anthnt/RSS_Capstone2021/CAD/DRAWINGS/Supplier Drawings/M13_4CQ4-PKG.JPG

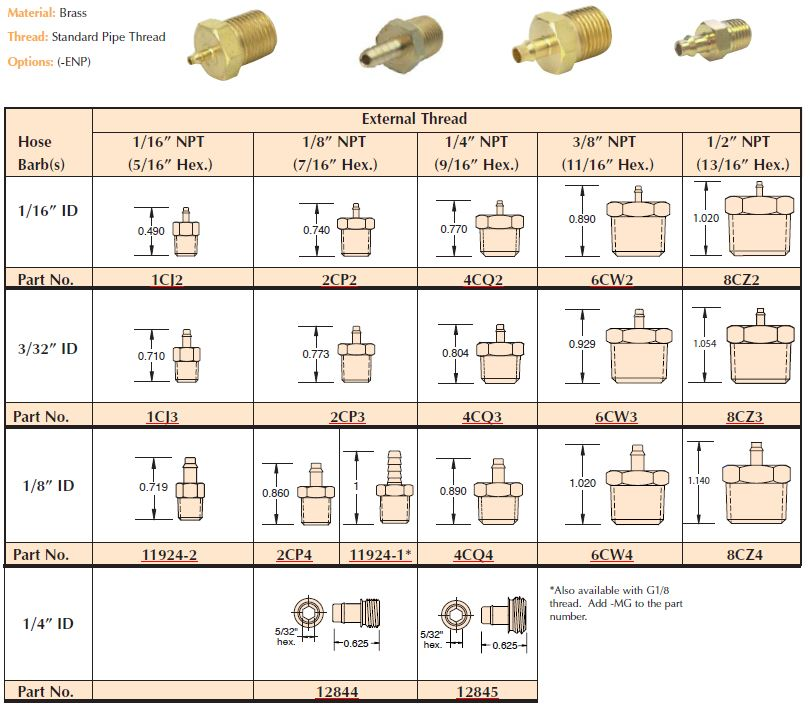
CAD/DRAWINGS/Supplier Drawings/M13_4CQ4-PKG.JPG
