anthnt/RSS_Capstone2021/CAD/DRAWINGS/Old/Not Necesssary/BOM.xlsx

ITEM NO. | PART NAME | DESCRIPTION | QTY
M1 | 4 x 10mm Manifold E10M-04 |  | 1
M2 | Ninja Cannister and First Stage Regulator |  | 1
M3 | Ninja Universal Fill Adapter (Not Depicted) |  | 1
M4 | Solenoid Valve E210A-1W012 |  | 4
M5 | 1/4" OD Nylon Tubing |  | 1
M6 | 1/8" ID Polyurethane Rubber Tubing |  | 1
M7 | 1/16" ID Polyurethane Rubber Tubing |  | 1
M9 | 1/4" Speedaire Regulator |  | 1
M10 | 1/8" ID Barb #10-32 Male Thread |  | 1
M11 | 1/16" ID Barb #10-32 Male Thread |  | 4
M12 | 1/8" NPT to 1/16" ID Barb (Not Depicted) |  | 1
M13 | 1/4” NPT to 1/8” ID Barb Fitting |  | 1
M14 | 1/8" FITTING PIPE PLUG SQUARE HEAD 1/8IN |  | 1
M17 | GAUGE CENTRE BACK MOUNT 0 - 160 PSI |  | 1
M18 | Brass Barbed Fittings ID 3/16" x 1/4" NTP Male |  | 1
M19 | Brass Barbed Fittings ID 3/16" x 1/8" NTP Male |  | 1
M20 | Creality 0.4mm Brass Nozzle |  | 4
M21 | 1/16" Barb ID x M6 x 1mm Male, Aluminum Low-Pressure |  | 4
M22 | 3 Nozzle Holder |  | 1
M23 | Load Cell Plate |  | 1
M24 | Nozzle Mount |  | 1
M25 | M2.5 x 0.45 mm, 15 mm long, 18-8 Stainless Steel Socket Head Screw |  | 4
M26 | M2.5 x 0.45 mm thread 18-8 Stainless Steel Hex Nut |  | 4
M27 | M6 x 1mm Thread Coupling Nut |  | 4
M28 | Air Cannister Holder |  | 2
M29 | Air Cannister Bracket |  | 2
M30 | Manifold Stand |  | 1
M31 | Base |  | 1
M32 | Second Stage Regulator Stand-Offs |  | 4
E5 | Load Cell |  | 1
