anthnt/RSS_Capstone2021/CAD/DRAWINGS/Supplier Drawings/M01_Manifold_E10M-04.jpg

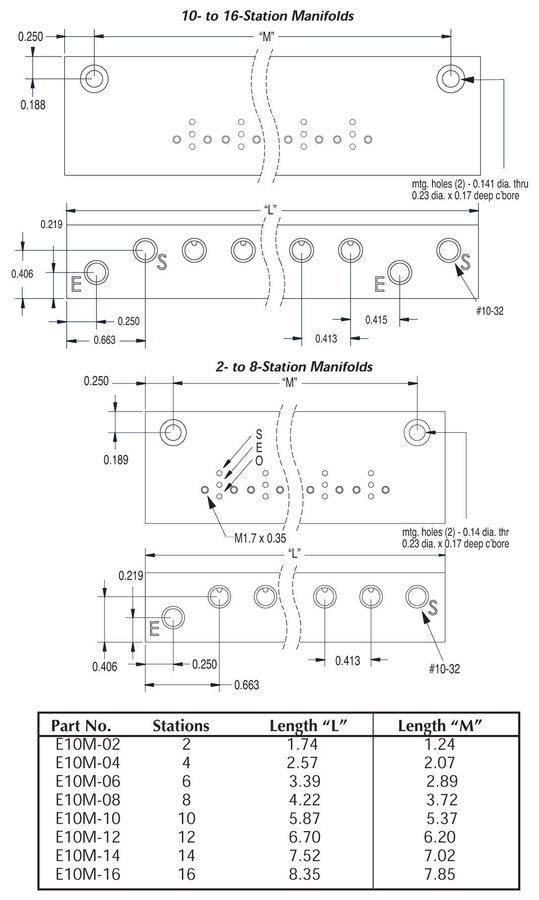
CAD/DRAWINGS/Supplier Drawings/M01_Manifold_E10M-04.jpg
