anthnt/RSS_Capstone2021/CAD/DRAWINGS/Supplier Drawings/M10_11752-4-pkg.jpg

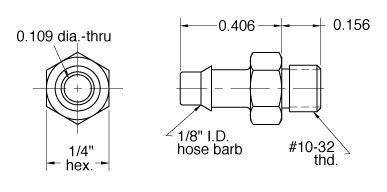
CAD/DRAWINGS/Supplier Drawings/M10_11752-4-pkg.jpg
