anthnt/RSS_Capstone2021/CAD/DRAWINGS/Supplier Drawings/M11_11752-5-pkg.jpg

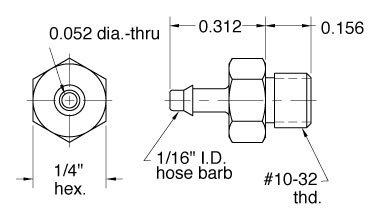
CAD/DRAWINGS/Supplier Drawings/M11_11752-5-pkg.jpg
