anthnt/RSS_Capstone2021/CAD/ASSM - Air Cannister/M2_NInja Canister and 1st Stage Regulator.SLDASM

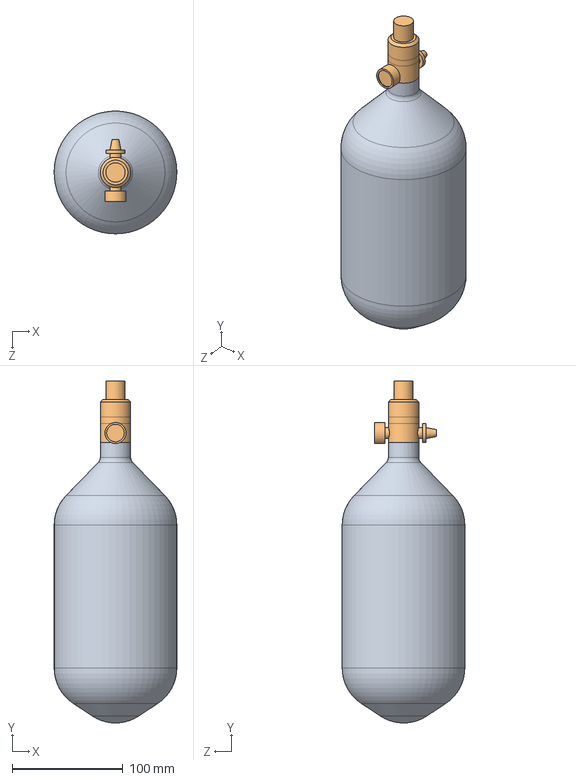
[picture p5: CAD file, 2022-05-25]
CAD/ASSM - Air Cannister/M2_NInja Canister and 1st Stage Regulator.SLDASM
110.7 x 308.5 x 110.7 mm
Ninja_NINJATANKSL2-90_(Air Canister)
Ninja_BLKRED-PROV2SL_(SLP Regulator)
