anthnt/RSS_Capstone2021/CAD/ASSM - 3 Nozzle Section/SUB_3 Nozzle Base Assmebly.SLDASM

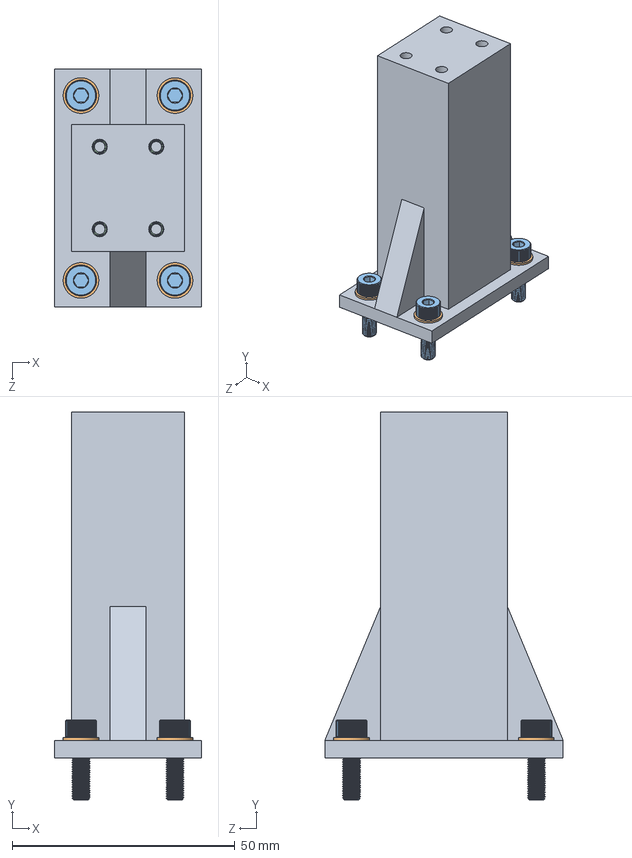
[picture p6: CAD file, 2022-05-25]
CAD/ASSM - 3 Nozzle Section/SUB_3 Nozzle Base Assmebly.SLDASM
33.1 x 87.1 x 53.5 mm
M22b_3 Nozzle Holder
M38_98689A113_General Purpose 18-8 Stainless Steel Washer x 4
M37_90751A118_18-8 Stainless Steel Socket Head Screws x 4
M42_91828A211_18-8 Stainless Steel Hex Nut x 4
