anthnt/RSS_Capstone2021/CAD/ASSM - Air Cannister/SUB_Air Canister Assembly.SLDASM

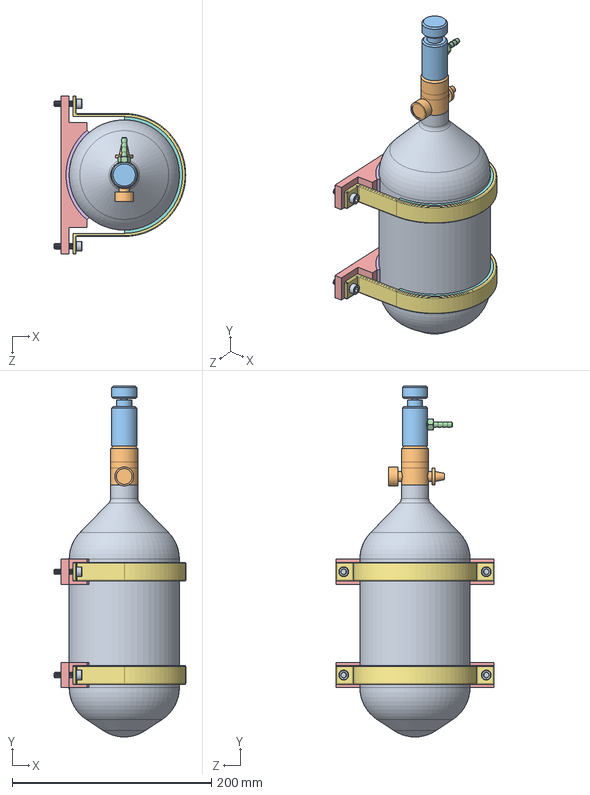
[picture p7: CAD file, 2022-05-25]
CAD/ASSM - Air Cannister/SUB_Air Canister Assembly.SLDASM
132.0 x 352.4 x 159.1 mm
Ninja_NINJATANKSL2-90_(Air Canister)
Ninja_BLKRED-PROV2SL_(SLP Regulator)
M3_Ninja_NINJATANK-FILLADAPTER_(Universal Fill Adapter)
M19_5346K11_Brass Barbed Hose Fitting for Air and Water
M28_Air Cannister Holder x 2
M33_Holder Rubber x 2
M29_Air Cannister Bracket x 2
M33_Bracket Rubber x 2
M35_91292A073_18-8 Stainless Steel Socket Head Screw x 4
