anthnt/RSS_Capstone2021/CAD/ASSM - Electrical Board/ElectricalAssembly.SLDASM

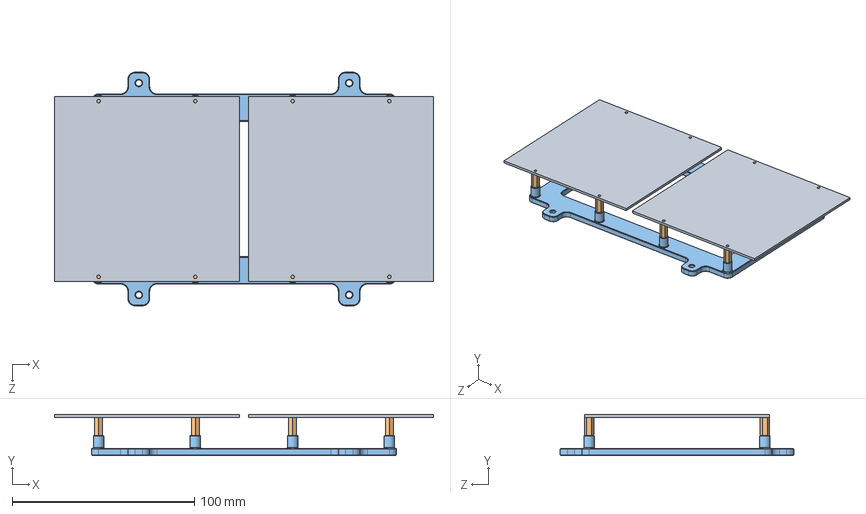
[picture p8: CAD file, 2022-05-25]
CAD/ASSM - Electrical Board/ElectricalAssembly.SLDASM
208.2 x 22.6 x 128.4 mm
PCB x 2
93655A096_Male-Female Threaded Hex Standoff x 8
ElectricalBoard_V2
