anthnt/RSS_Capstone2021/CAD/ASSM - Nozzle Assembly/Custom Nozzle Assembly.SLDASM

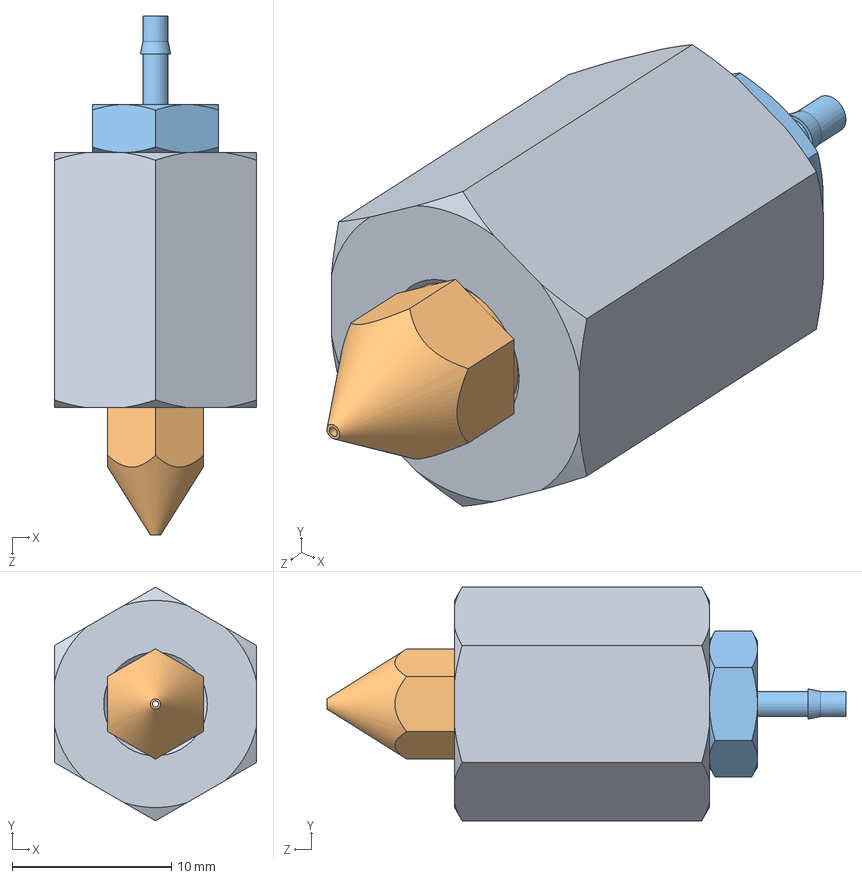
[picture p9: CAD file, 2022-05-25]
CAD/ASSM - Nozzle Assembly/Custom Nozzle Assembly.SLDASM
12.7 x 14.7 x 32.6 mm
M27_93020A775_LOW-STRENGTH STL HEX CPLG NUT
M20_Creality Brass Nozzle
M21_5058K956_ALUMINUM LOW-PRESSURE BARBED TUBE FITTING
