anthnt/RSS_Capstone2021/CAD/ASSM - Solenoid Valves and Manifold/M04_valve_e210a-1w012.SLDASM

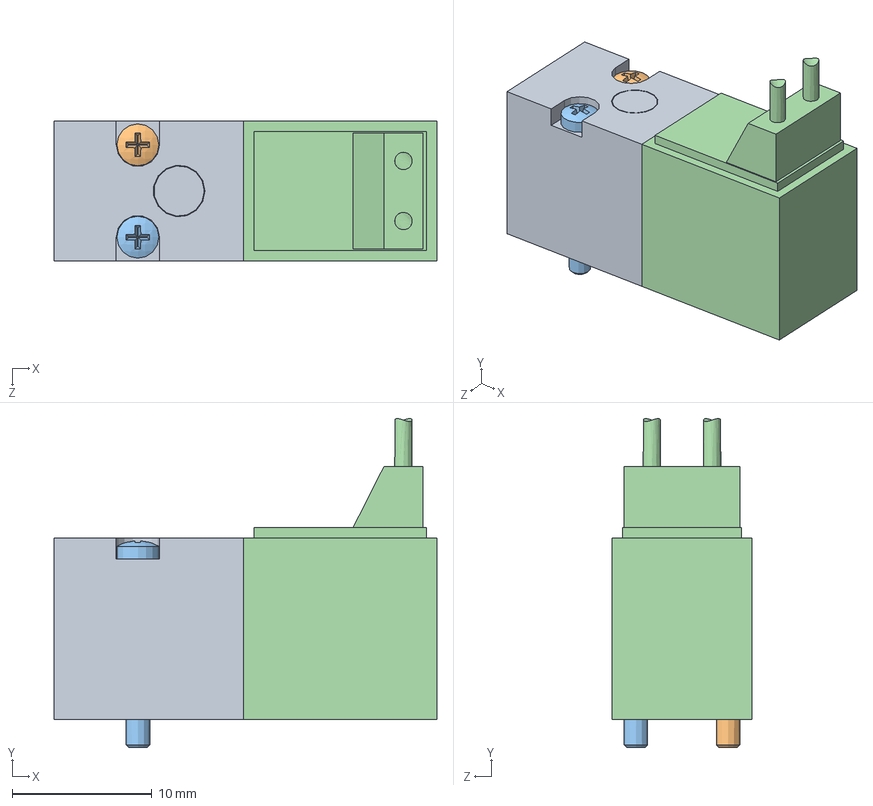
[picture p10: CAD file, 2022-05-25]
CAD/ASSM - Solenoid Valves and Manifold/M04_valve_e210a-1w012.SLDASM
27.4 x 23.5 x 10.0 mm
valve_e210a-1w012_01
valve_e210a-1w012_02
valve_e210a-1w012_03
valve_e210a-1w012_04
