anthnt/RSS_Capstone2021/CAD/ASSM - Load Cell/SUB_Load Cell Mounting Assembly.SLDASM

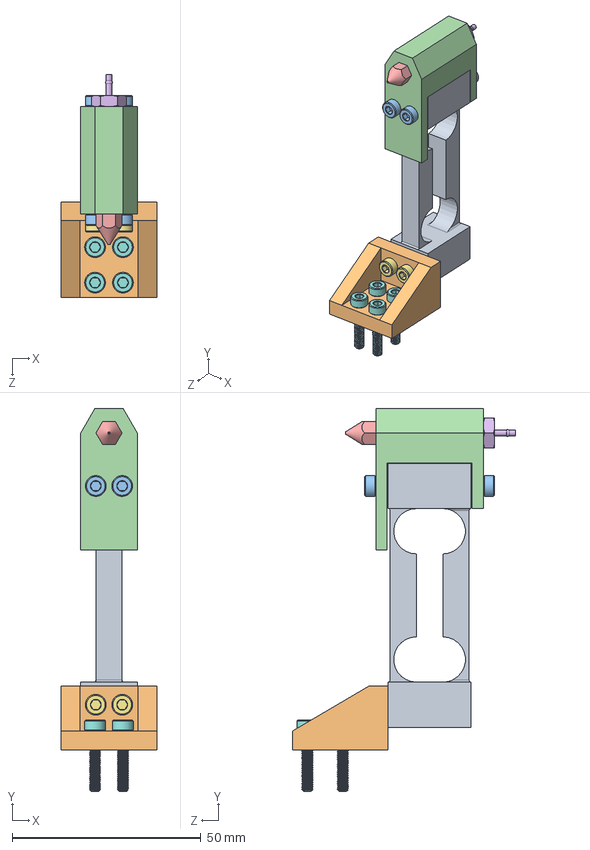
[picture p11: CAD file, 2022-05-25]
CAD/ASSM - Load Cell/SUB_Load Cell Mounting Assembly.SLDASM
25.4 x 101.5 x 59.2 mm
E05_Load Cell
M23_Load Cell Bracket
M44_91292A113_18-8 Stainless Steel Socket Head Screw x 4
M24_Nozzle Mount
M20_Creality Brass Nozzle
M21_5058K956_ALUMINUM LOW-PRESSURE BARBED TUBE FITTING
M41_91292A801_18-8 Stainless Steel Socket Head Screw x 2
M25_91292A115_18-8 Stainless Steel Socket Head Screw x 4
