anthnt/RSS_Capstone2021/CAD/ASSM - Solenoid Valves and Manifold/SUB_Solenoid Assembly.SLDASM

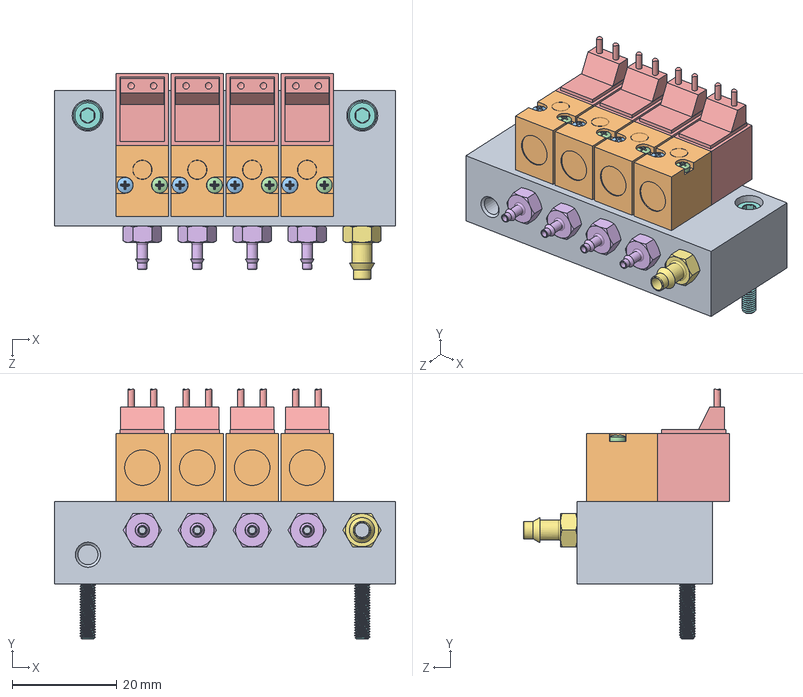
[picture p12: CAD file, 2022-05-25]
CAD/ASSM - Solenoid Valves and Manifold/SUB_Solenoid Assembly.SLDASM
65.2 x 47.8 x 39.5 mm
M01_manifold_e10m-04
valve_e210a-1w012_01 x 4
valve_e210a-1w012_02 x 4
valve_e210a-1w012_03 x 4
valve_e210a-1w012_04 x 4
M11_11752-5-pkg x 4
M10_11752-4-pkg
91292A801_18-8 Stainless Steel Socket Head Screw x 2
