anthnt/RSS_Capstone2021/CAD/ASSM - 3 Nozzle Section/SUB_3 Nozzle Block Assembly.SLDASM

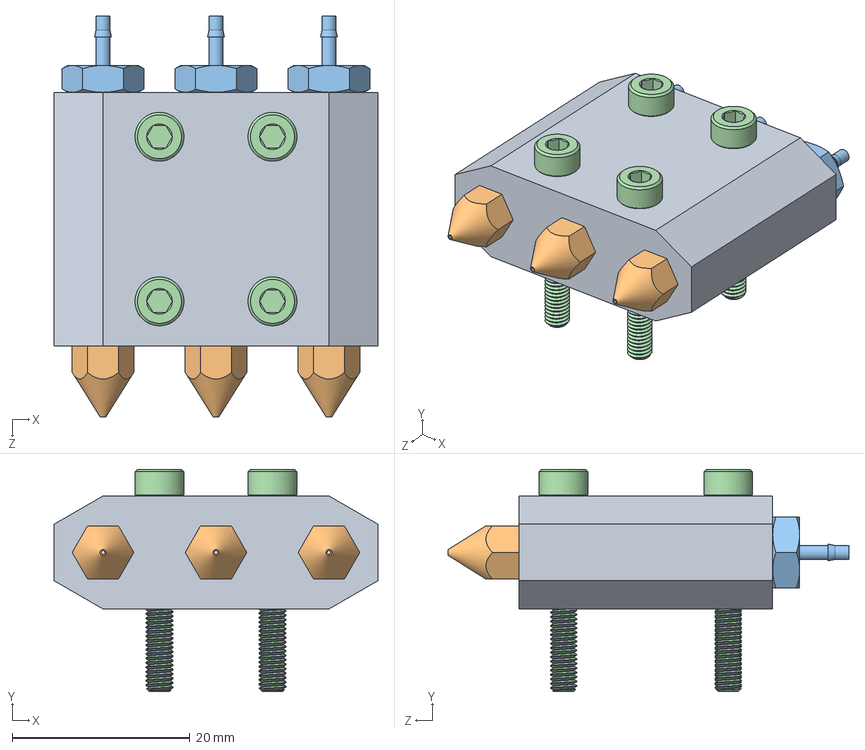
[picture p13: CAD file, 2022-05-25]
CAD/ASSM - 3 Nozzle Section/SUB_3 Nozzle Block Assembly.SLDASM
36.4 x 25.0 x 45.1 mm
M22a_3 Nozzle Block
M20_Creality Brass Nozzle x 3
M21_5058K956_ALUMINUM LOW-PRESSURE BARBED TUBE FITTING x 3
M41_91292A801_18-8 Stainless Steel Socket Head Screw x 4
