anthnt/RSS_Capstone2021/CAD/ASSM - Load Cell/SUB_Calibration Stand Mounting Assembly.SLDASM

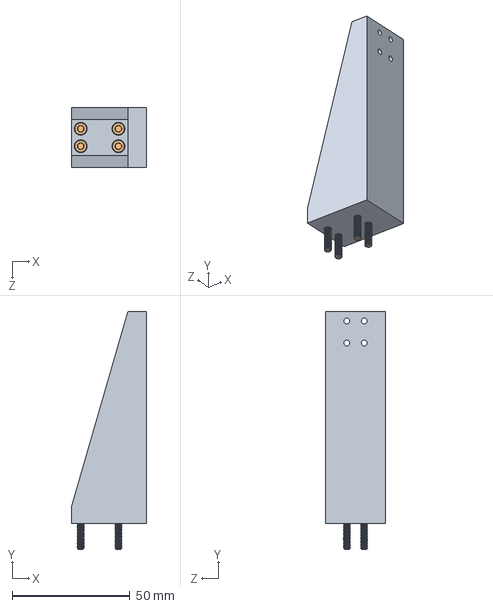
[picture p14: CAD file, 2022-05-25]
CAD/ASSM - Load Cell/SUB_Calibration Stand Mounting Assembly.SLDASM
32.0 x 101.0 x 25.4 mm
M40_Calibration Stand
M43_91292A029_18-8 Stainless Steel Socket Head Screw x 4
