anthnt/RSS_Capstone2021/CAD/ASSM - Second Stage Regulator/SUB_Second Stage Regulator Assembly.SLDASM

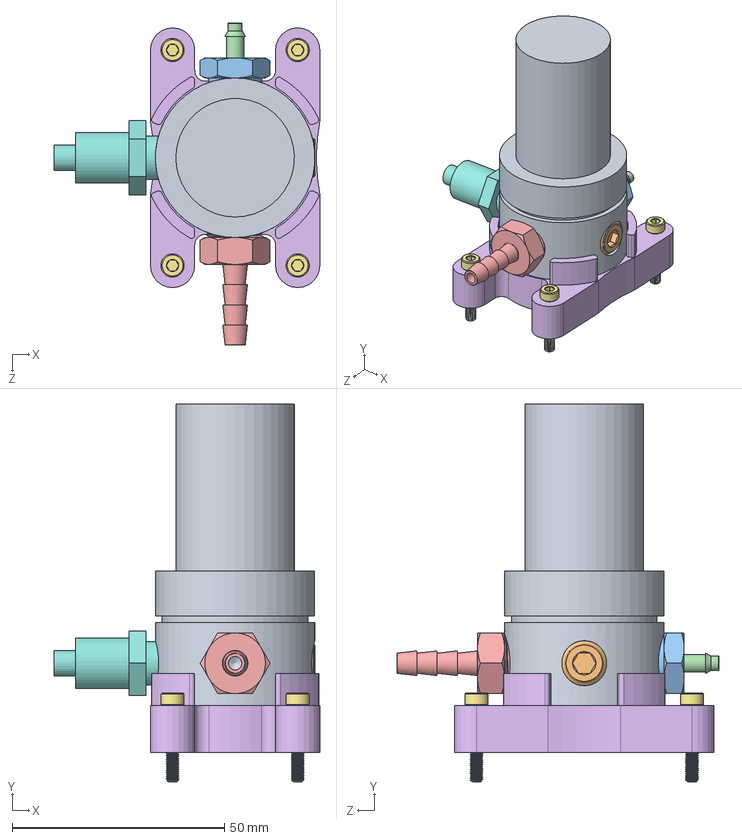
[picture p15: CAD file, 2022-05-25]
CAD/ASSM - Second Stage Regulator/SUB_Second Stage Regulator Assembly.SLDASM
62.6 x 89.1 x 76.0 mm
Grainger_4ZM06_(Pressure Regulator)
MCMASTER_4464K561_(0.125 NPT Plug Fitting)
4cq4-pkg_01
4cq4-pkg_02
M18_5346K12_Brass Barbed Hose Fitting for Air and Water
Regulator Base Fixture
M43_91292A029_18-8 Stainless Steel Socket Head Screw x 4
Pressure Transducer
