anthnt/RSS_Capstone2021/CAD/ASSM - Second Stage Regulator/4cq4-pkg.SLDASM

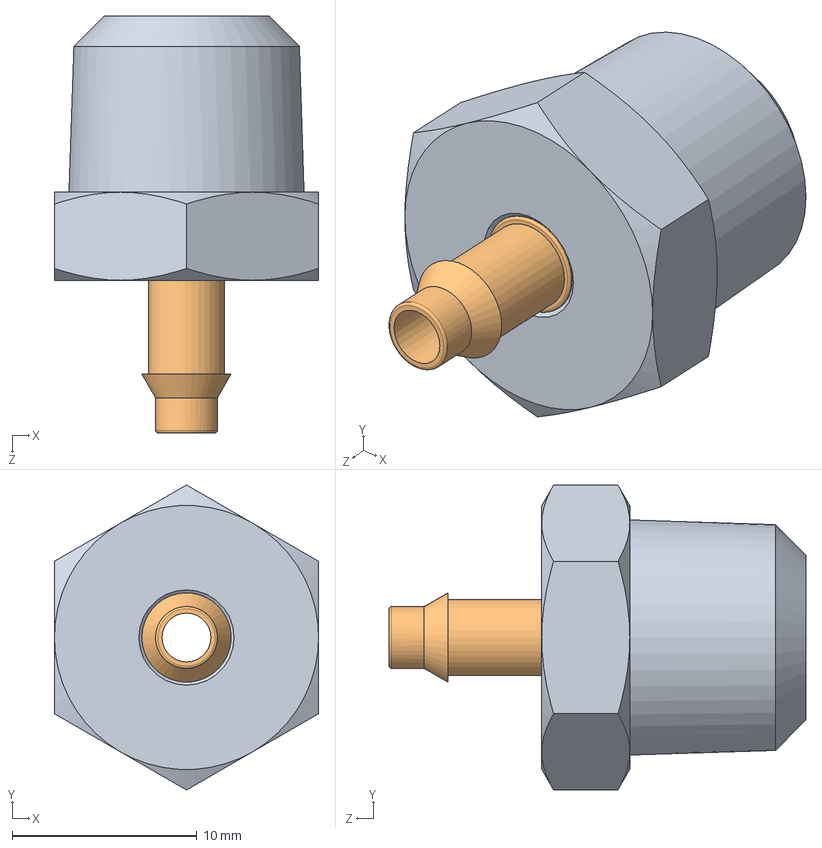
[picture p16: CAD file, 2022-05-25]
CAD/ASSM - Second Stage Regulator/4cq4-pkg.SLDASM
14.3 x 16.5 x 22.5 mm
4cq4-pkg_01
4cq4-pkg_02
