anthnt/RSS_Capstone2021/CAD/ASSM - Electrical Board/ElectricalBoard_V2.SLDPRT

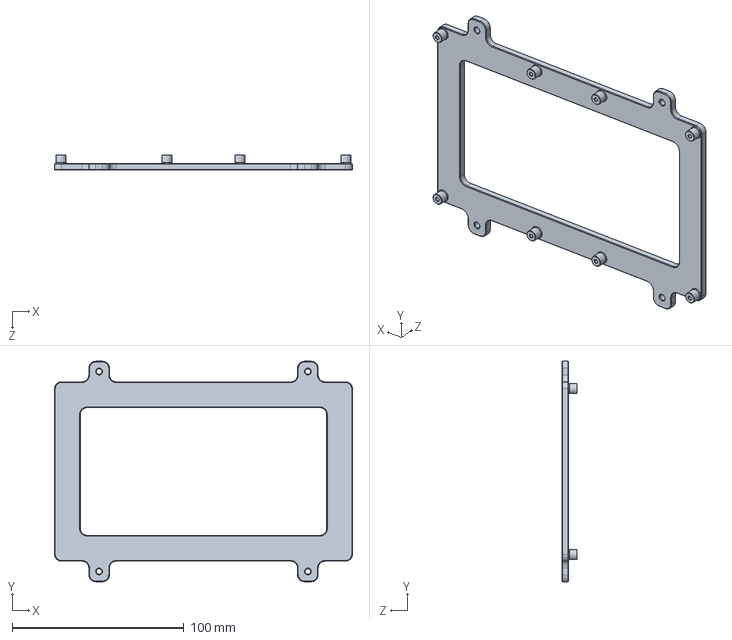
[picture p17: CAD file, 2022-05-25]
CAD/ASSM - Electrical Board/ElectricalBoard_V2.SLDPRT
173.5 x 128.4 x 9.00 mm
