anthnt/RSS_Capstone2021/CAD/ASSM - Nozzle Assembly/M20_Creality Brass Nozzle.SLDPRT

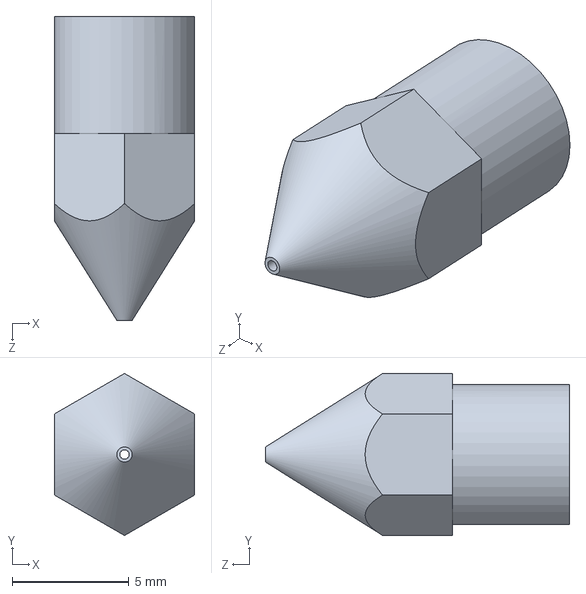
[picture p18: CAD file, 2022-05-25]
CAD/ASSM - Nozzle Assembly/M20_Creality Brass Nozzle.SLDPRT
6.00 x 6.93 x 13.0 mm
