anthnt/RSS_Capstone2021/CAD/ASSM - Prototyping Bed/PrototypeBase.SLDPRT

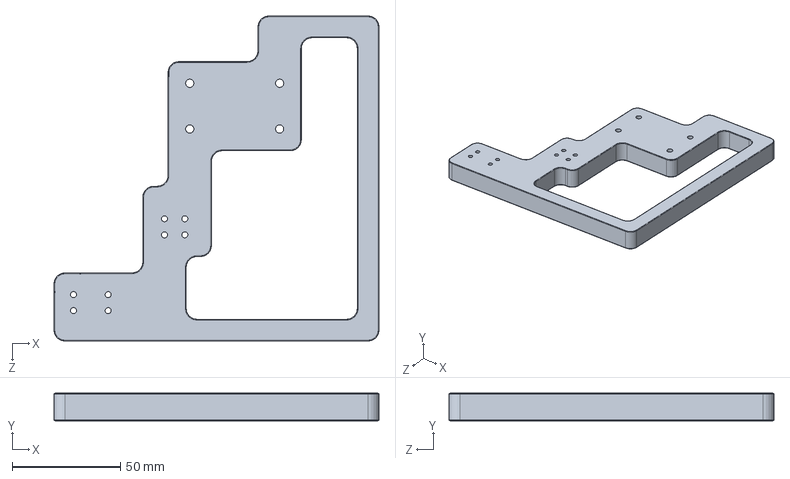
[picture p19: CAD file, 2022-05-25]
CAD/ASSM - Prototyping Bed/PrototypeBase.SLDPRT
150.0 x 12.7 x 150.0 mm
