anthnt/RSS_Capstone2021/CAD/Base.SLDPRT

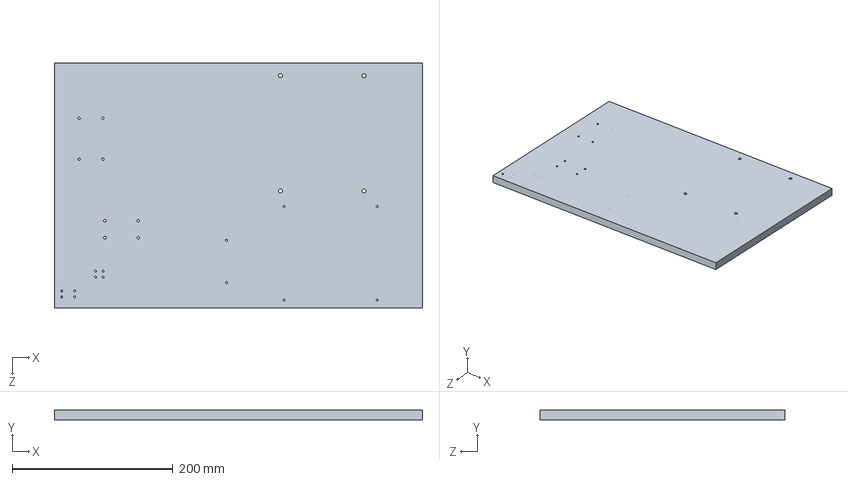
[picture p20: CAD file, 2022-05-25]
CAD/Base.SLDPRT
457.2 x 12.7 x 304.8 mm
