anthnt/RSS_Capstone2021/CAD/DRAWINGS/Air Cannister Holder/Air Cannister Holder.SLDPRT

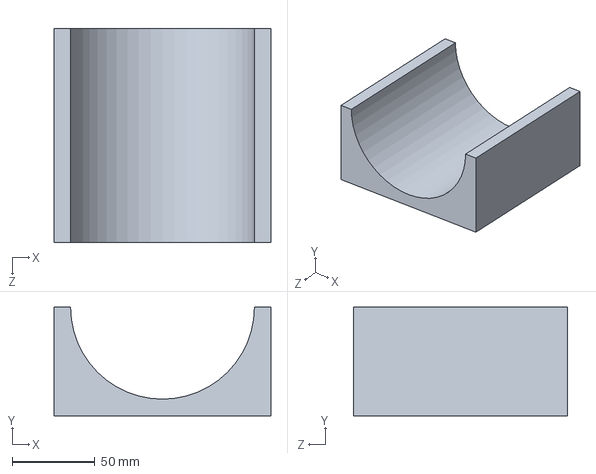
[picture p21: CAD file, 2022-05-25]
CAD/DRAWINGS/Air Cannister Holder/Air Cannister Holder.SLDPRT
130.7 x 65.4 x 129.1 mm
