anthnt/RSS_Capstone2021/CAD/PARTS - Circuit Boards/Protoboard.SLDPRT

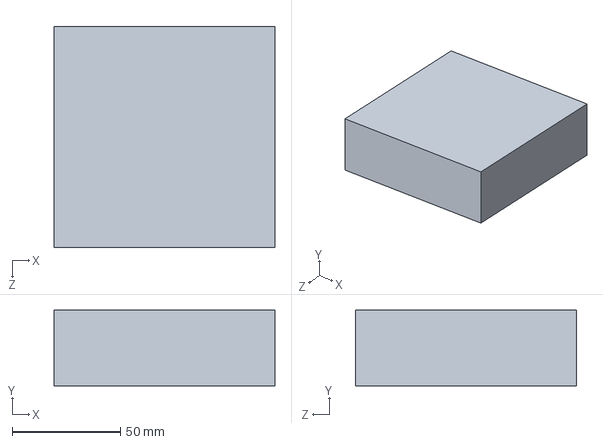
[picture p22: CAD file, 2022-05-25]
CAD/PARTS - Circuit Boards/Protoboard.SLDPRT
102.0 x 35.0 x 102.0 mm
