anthnt/RSS_Capstone2021/CAD/PARTS - Prototype Thrusters/ConvergingDiverging_T1_E1.1645.SLDPRT

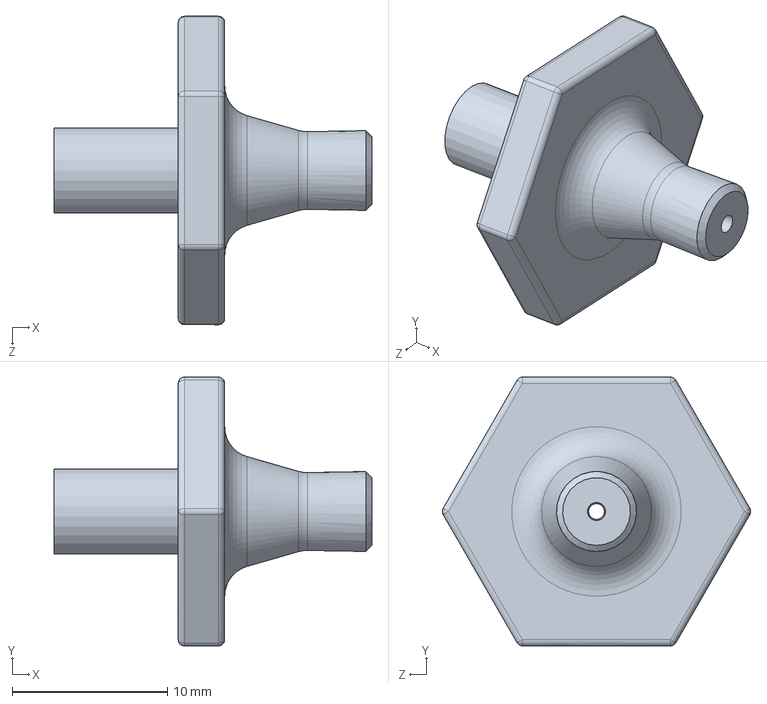
[picture p23: CAD file, 2022-05-25]
CAD/PARTS - Prototype Thrusters/ConvergingDiverging_T1_E1.1645.SLDPRT
20.5 x 17.3 x 19.9 mm
