anthnt/RSS_Capstone2021/CAD/PARTS - Tubing/Air Cannister Tube.SLDPRT

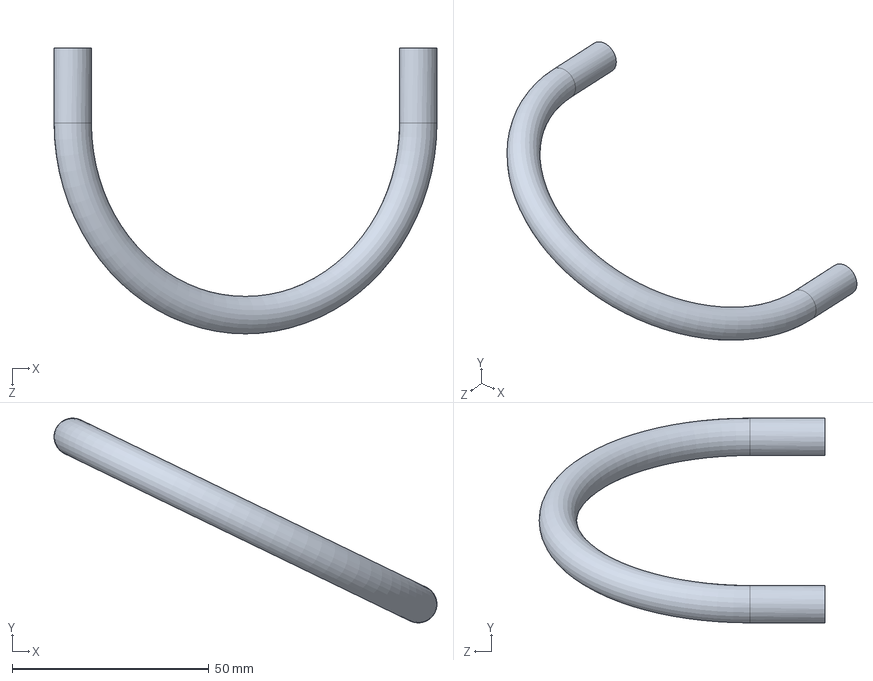
[picture p24: CAD file, 2022-05-25]
CAD/PARTS - Tubing/Air Cannister Tube.SLDPRT
97.3 x 52.0 x 72.6 mm
