anthnt/RSS_Capstone2021/CAD/ASSM - 3 Nozzle Section/M22b_3 Nozzle Holder.SLDPRT

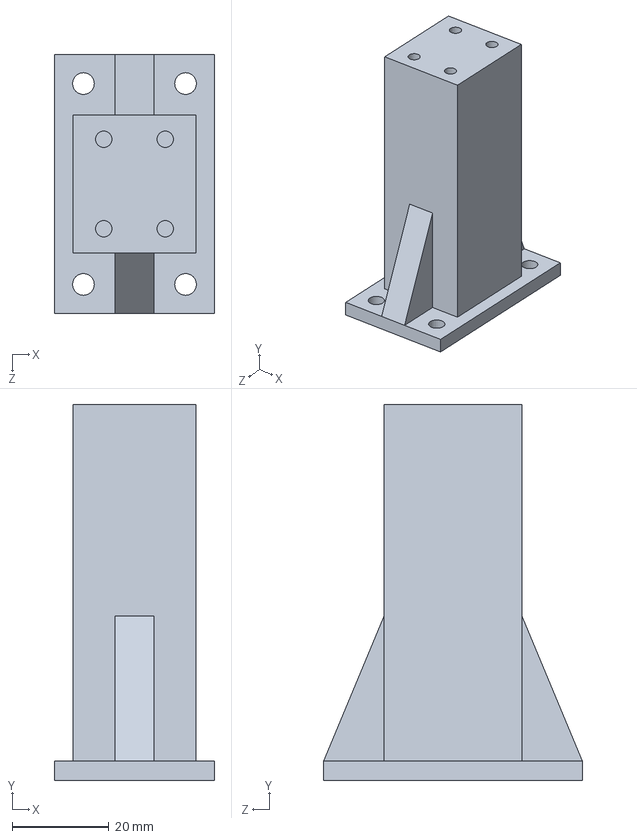
[picture p25: CAD file, 2022-05-25]
CAD/ASSM - 3 Nozzle Section/M22b_3 Nozzle Holder.SLDPRT
33.1 x 77.7 x 53.5 mm
