anthnt/RSS_Capstone2021/CAD/ASSM - Solenoid Valves and Manifold/M01_manifold_e10m-04.SLDPRT

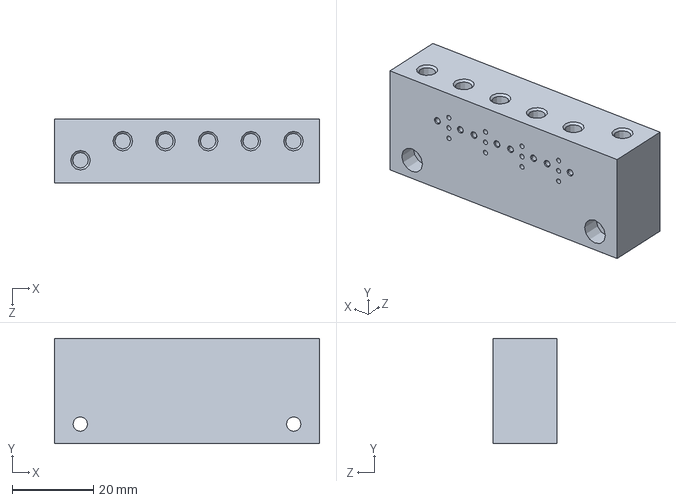
[picture p26: CAD file, 2022-05-25]
CAD/ASSM - Solenoid Valves and Manifold/M01_manifold_e10m-04.SLDPRT
65.2 x 25.9 x 15.8 mm
