anthnt/RSS_Capstone2021/CAD/PARTS - Tubing/Nozzle Tubes.SLDPRT

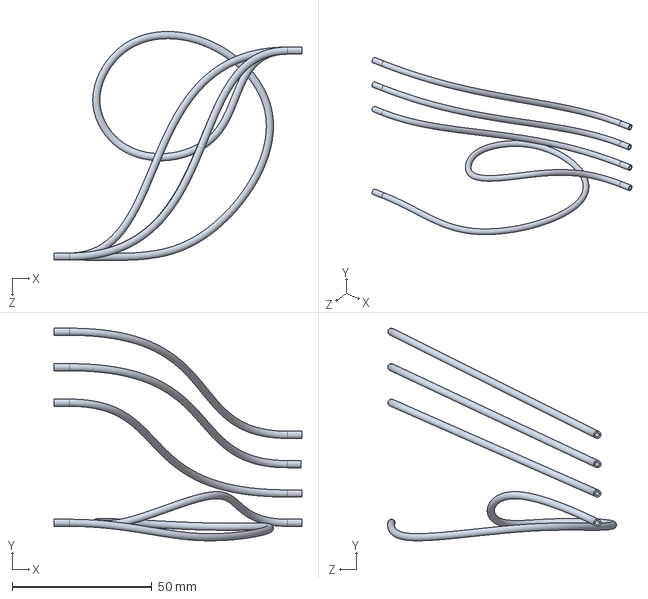
[picture p27: CAD file, 2022-05-25]
CAD/PARTS - Tubing/Nozzle Tubes.SLDPRT
88.8 x 76.2 x 82.0 mm
