anthnt/RSS_Capstone2021/CAD/ASSM - Load Cell/Pressure Transducer.SLDPRT

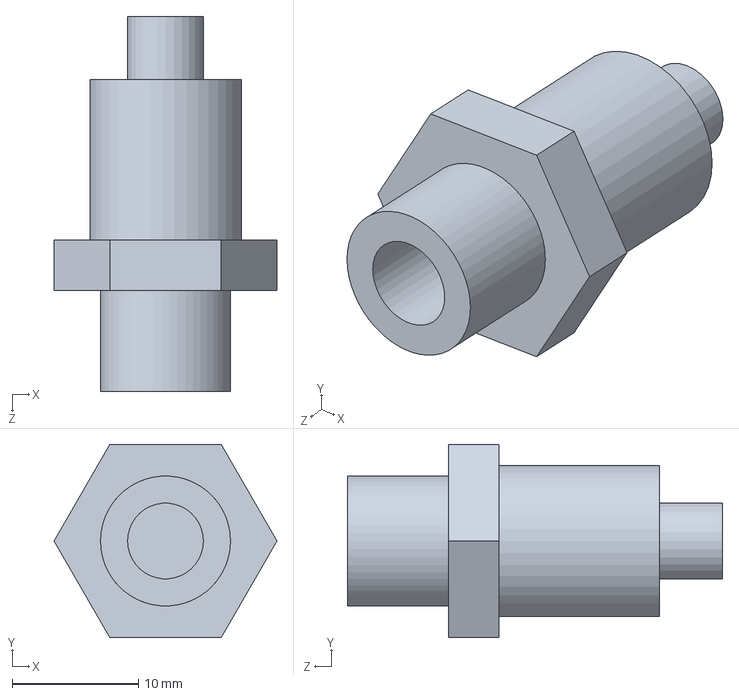
[picture p28: CAD file, 2022-05-25]
CAD/ASSM - Load Cell/Pressure Transducer.SLDPRT
17.7 x 15.3 x 29.7 mm
