anthnt/RSS_Capstone2021/CAD/PARTS - Tubing/Regulator-Manifold Tube.SLDPRT

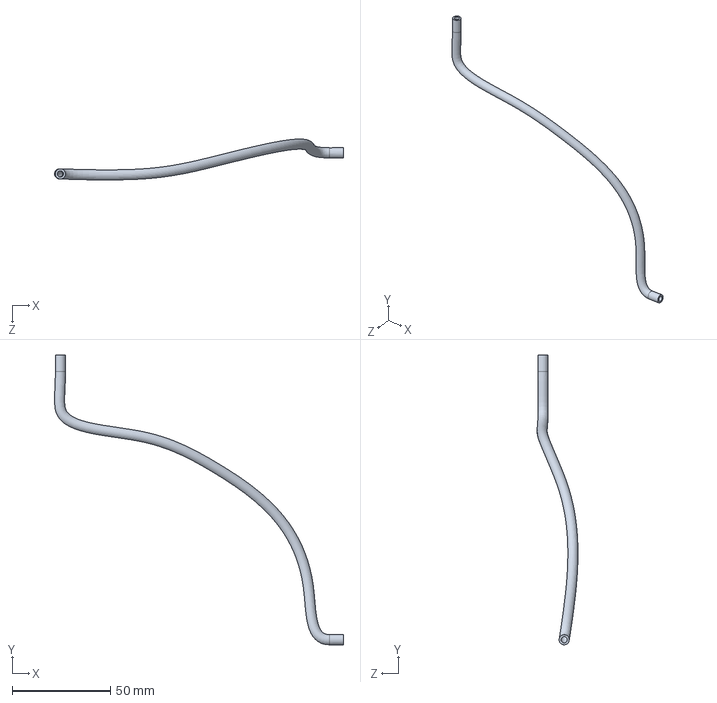
[picture p29: CAD file, 2022-05-25]
CAD/PARTS - Tubing/Regulator-Manifold Tube.SLDPRT
147.1 x 147.5 x 20.8 mm
