anthnt/RSS_Capstone2021/CAD/ASSM - Air Cannister/Ninja_NINJATANKSL2-90_(Air Canister).SLDPRT

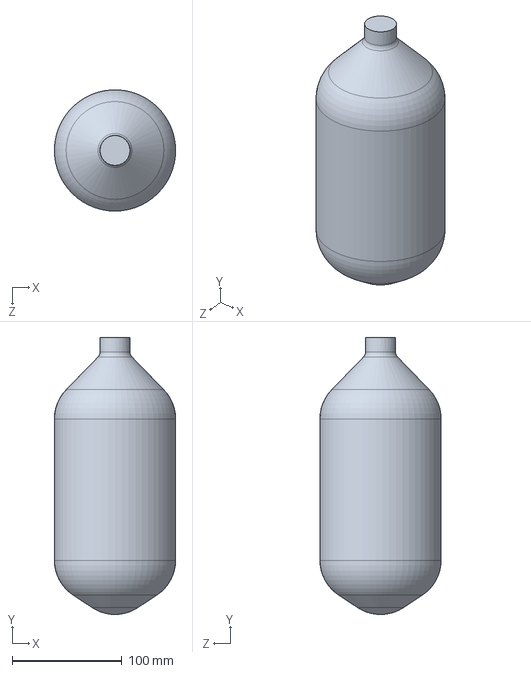
[picture p30: CAD file, 2022-05-25]
CAD/ASSM - Air Cannister/Ninja_NINJATANKSL2-90_(Air Canister).SLDPRT
110.7 x 252.8 x 110.7 mm
