anthnt/RSS_Capstone2021/CAD/ASSM - Electrical Board/HX711.SLDPRT

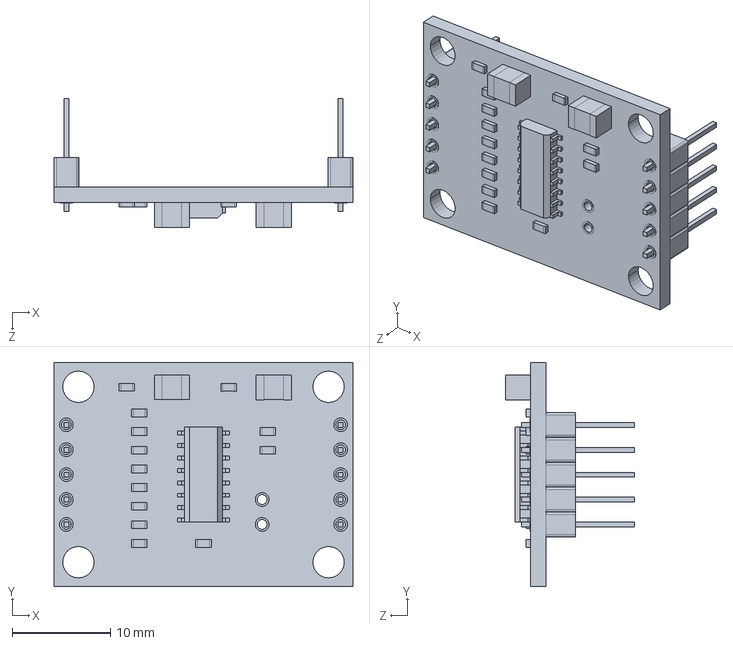
[picture p31: CAD file, 2022-05-25]
CAD/ASSM - Electrical Board/HX711.SLDPRT
30.5 x 22.9 x 13.1 mm
