anthnt/RSS_Capstone2021/CAD/ASSM - Load Cell/E05_Load Cell.SLDPRT

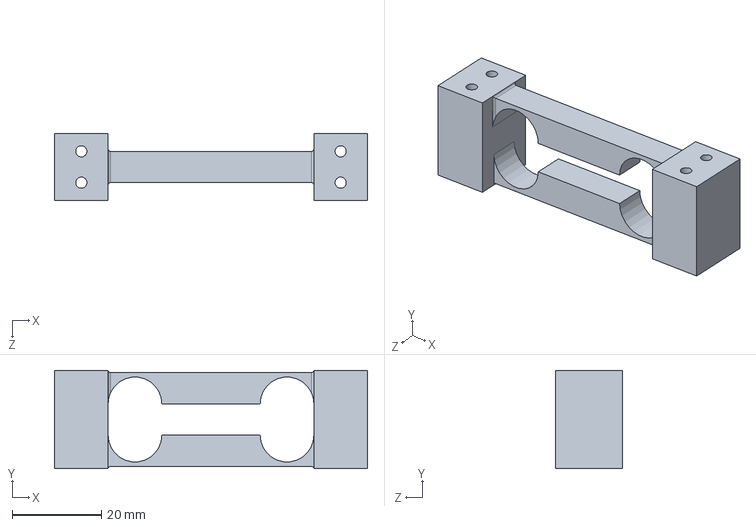
[picture p32: CAD file, 2022-05-25]
CAD/ASSM - Load Cell/E05_Load Cell.SLDPRT
70.0 x 22.0 x 15.0 mm
