anthnt/RSS_Capstone2021/CAD/ASSM - Air Cannister/M33_Bracket Rubber.SLDPRT

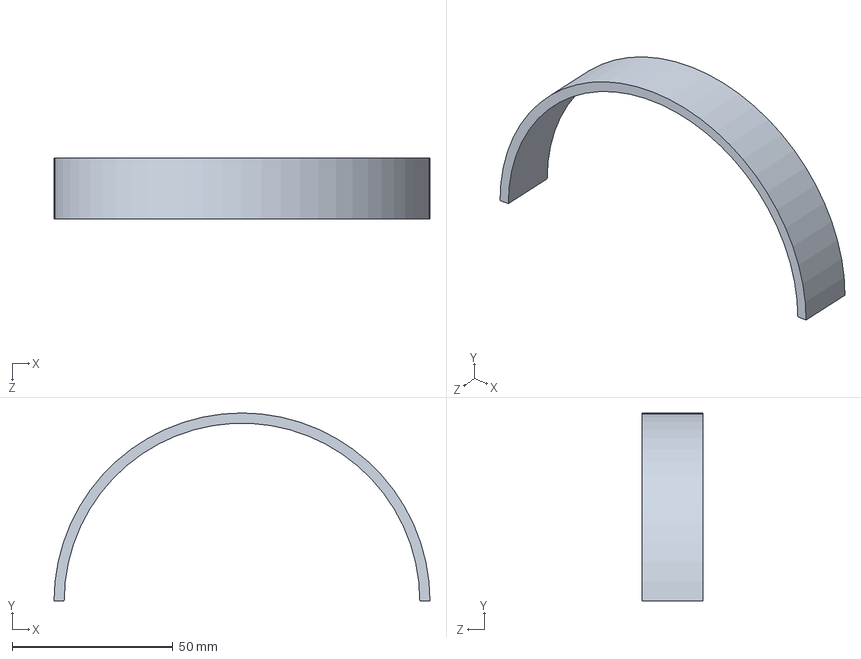
[picture p33: CAD file, 2022-05-25]
CAD/ASSM - Air Cannister/M33_Bracket Rubber.SLDPRT
117.1 x 58.5 x 19.1 mm
