anthnt/RSS_Capstone2021/CAD/ASSM - Electrical Board/PCB.SLDPRT

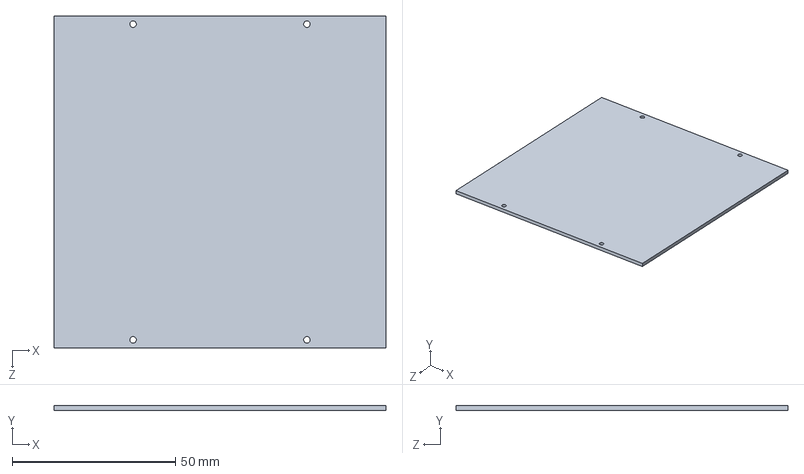
[picture p34: CAD file, 2022-05-25]
CAD/ASSM - Electrical Board/PCB.SLDPRT
101.6 x 1.57 x 101.6 mm
