anthnt/RSS_Capstone2021/CAD/ASSM - 3 Nozzle Section/M22a_3 Nozzle Block.SLDPRT

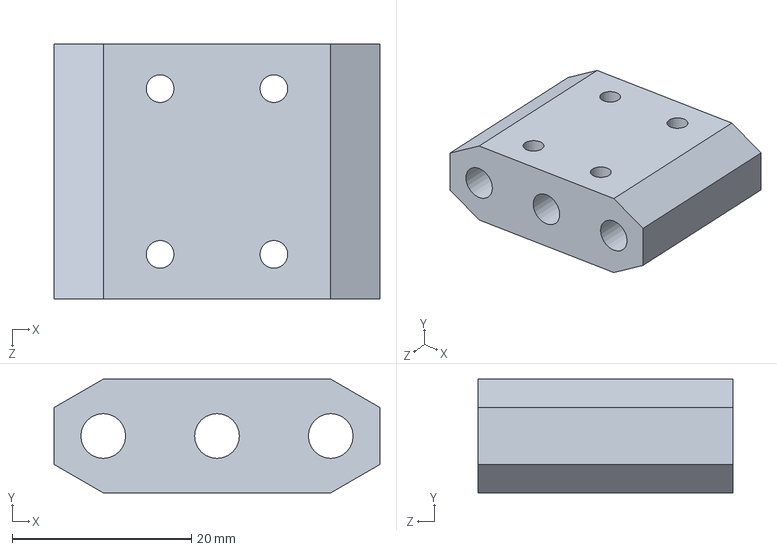
[picture p35: CAD file, 2022-05-25]
CAD/ASSM - 3 Nozzle Section/M22a_3 Nozzle Block.SLDPRT
36.4 x 12.7 x 28.5 mm
