anthnt/RSS_Capstone2021/CAD/ASSM - Air Cannister/M29_Air Cannister Bracket.SLDPRT

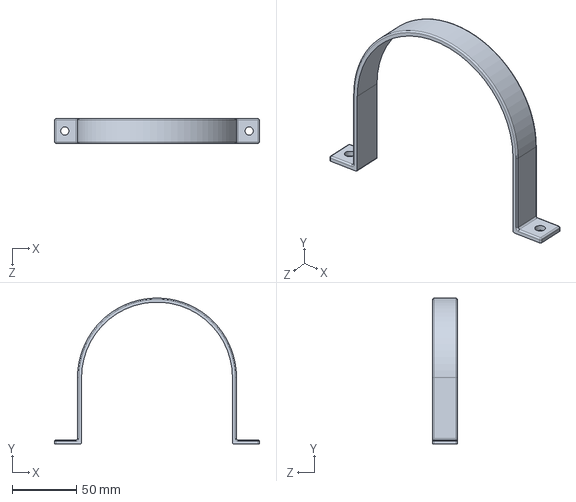
[picture p36: CAD file, 2022-05-25]
CAD/ASSM - Air Cannister/M29_Air Cannister Bracket.SLDPRT
159.1 x 113.2 x 19.1 mm
