anthnt/RSS_Capstone2021/CAD/ASSM - Air Cannister/Ninja_BLKRED-PROV2SL_(SLP Regulator).SLDPRT

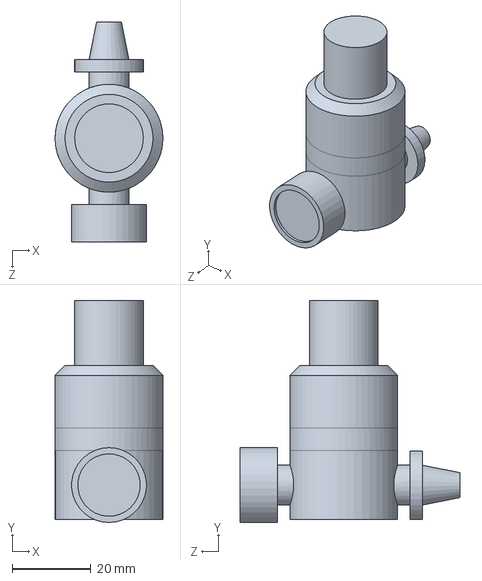
[picture p37: CAD file, 2022-05-25]
CAD/ASSM - Air Cannister/Ninja_BLKRED-PROV2SL_(SLP Regulator).SLDPRT
27.4 x 56.5 x 56.0 mm
