anthnt/RSS_Capstone2021/CAD/ASSM - Load Cell/M24_Nozzle Mount.SLDPRT

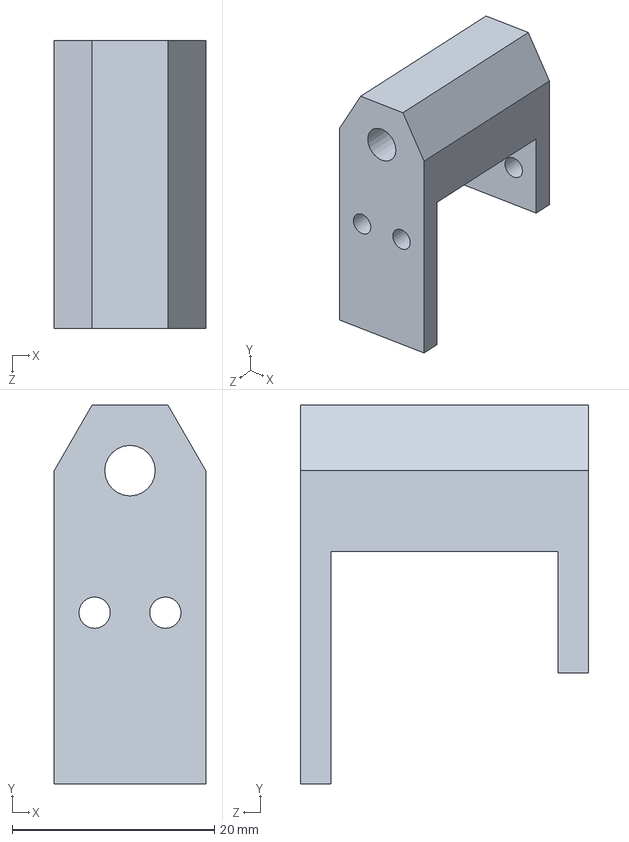
[picture p38: CAD file, 2022-05-25]
CAD/ASSM - Load Cell/M24_Nozzle Mount.SLDPRT
15.0 x 37.5 x 28.5 mm
