anthnt/RSS_Capstone2021/CAD/ASSM - Second Stage Regulator/Regulator Base Fixture.SLDPRT

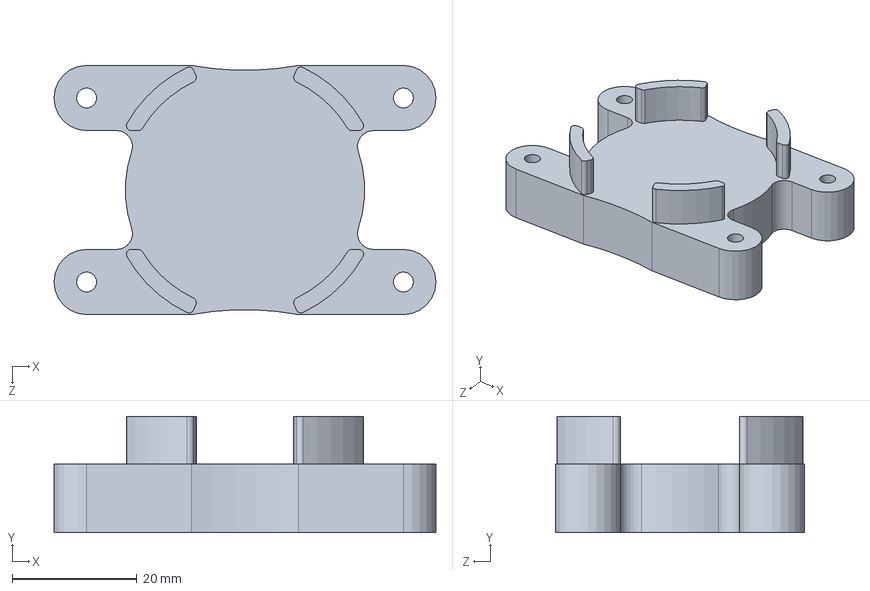
[picture p39: CAD file, 2022-05-25]
CAD/ASSM - Second Stage Regulator/Regulator Base Fixture.SLDPRT
61.2 x 18.7 x 39.9 mm
