anthnt/RSS_Capstone2021/CAD/ASSM - Air Cannister/M3_Ninja_NINJATANK-FILLADAPTER_(Universal Fill Adapter).SLDPRT

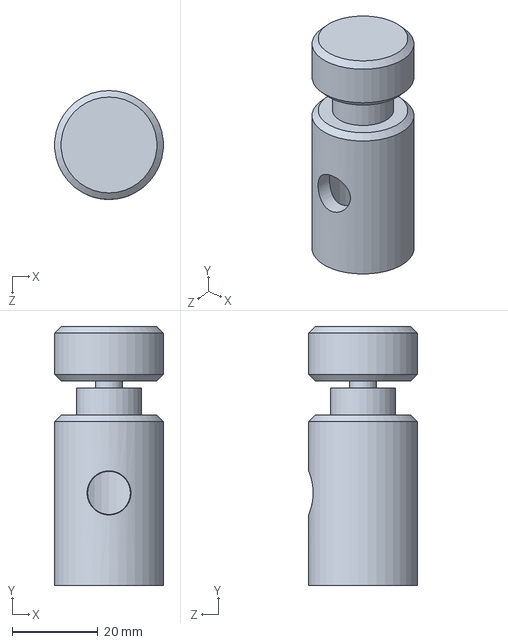
[picture p40: CAD file, 2022-05-25]
CAD/ASSM - Air Cannister/M3_Ninja_NINJATANK-FILLADAPTER_(Universal Fill Adapter).SLDPRT
25.3 x 60.4 x 25.4 mm
