anthnt/RSS_Capstone2021/CAD/ASSM - Load Cell/M23_Load Cell Bracket.SLDPRT

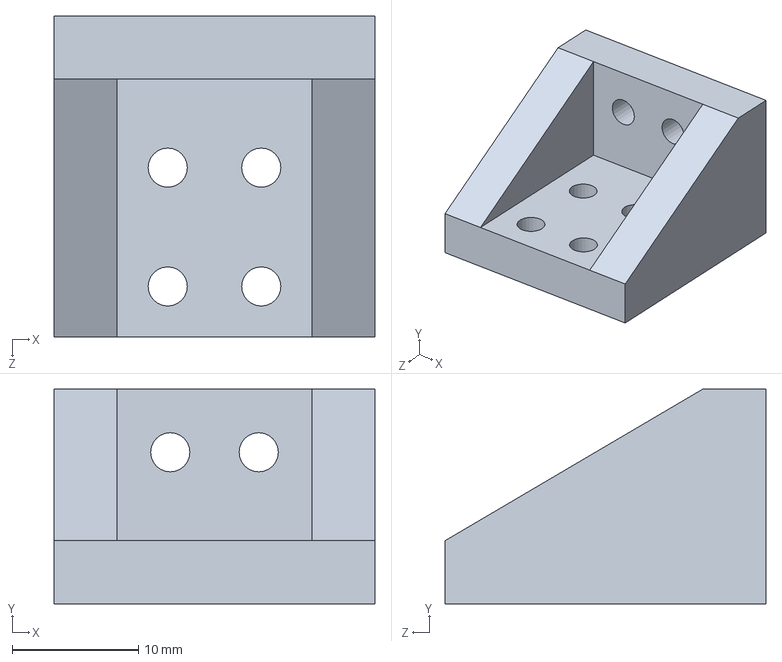
[picture p41: CAD file, 2022-05-25]
CAD/ASSM - Load Cell/M23_Load Cell Bracket.SLDPRT
25.4 x 17.0 x 25.4 mm
