anthnt/RSS_Capstone2021/CAD/ASSM - Second Stage Regulator/Grainger_4ZM06_(Pressure Regulator).SLDPRT

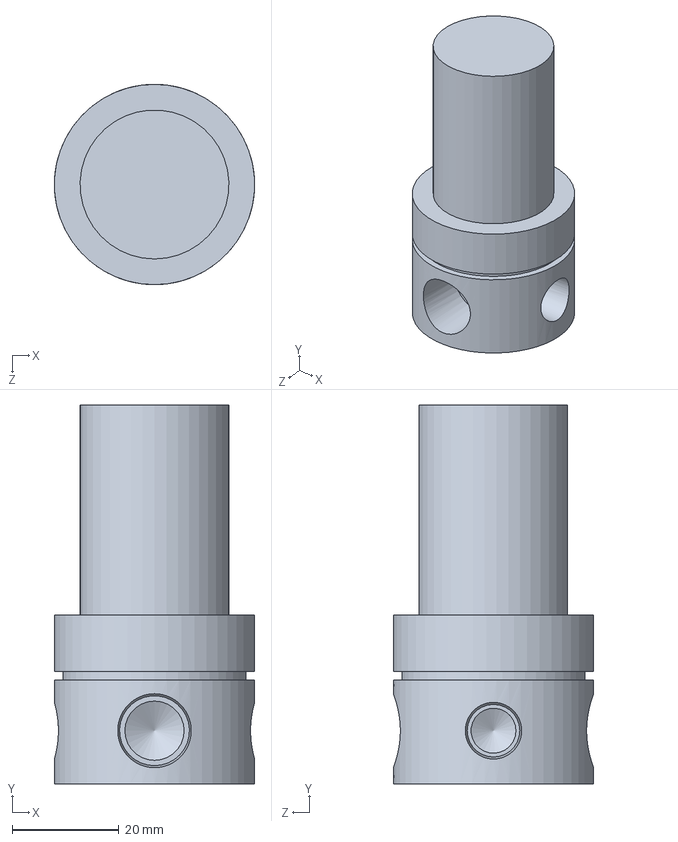
[picture p42: CAD file, 2022-05-25]
CAD/ASSM - Second Stage Regulator/Grainger_4ZM06_(Pressure Regulator).SLDPRT
37.6 x 71.1 x 37.6 mm
