anthnt/RSS_Capstone2021/CAD/ASSM - Air Cannister/M33_Holder Rubber.SLDPRT

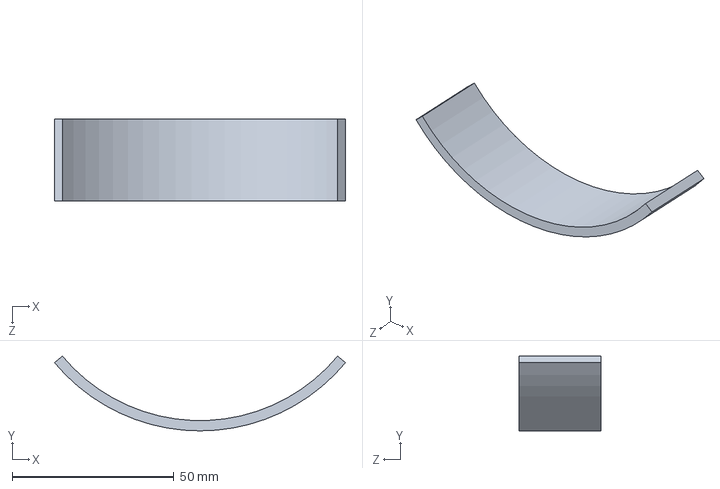
[picture p43: CAD file, 2022-05-25]
CAD/ASSM - Air Cannister/M33_Holder Rubber.SLDPRT
90.0 x 23.1 x 25.4 mm
