anthnt/RSS_Capstone2021/CAD/ASSM - Air Cannister/2 x M28_Air Cannister Holder.3mf

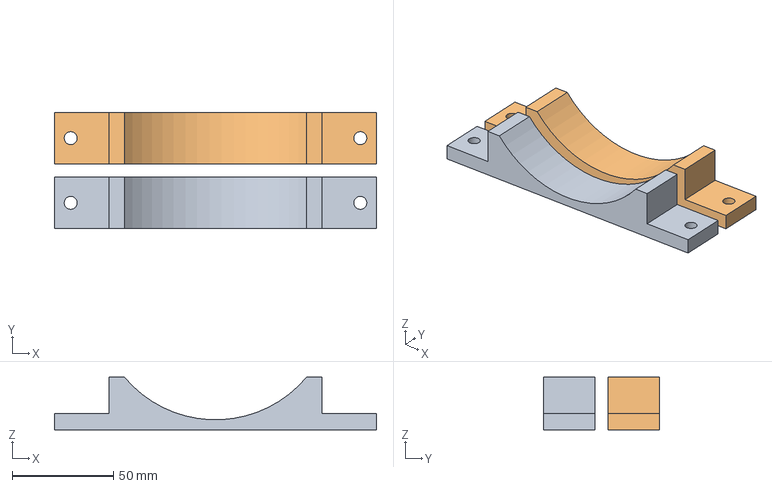
[picture p44: CAD file, 2022-05-25]
CAD/ASSM - Air Cannister/2 x M28_Air Cannister Holder.3mf
159.1 x 57.4 x 26.1 mm
M28_Air Cannister Holder.STL x 2
