anthnt/RSS_Capstone2021/CAD/ASSM - Second Stage Regulator/4cq4-pkg_02.SLDPRT

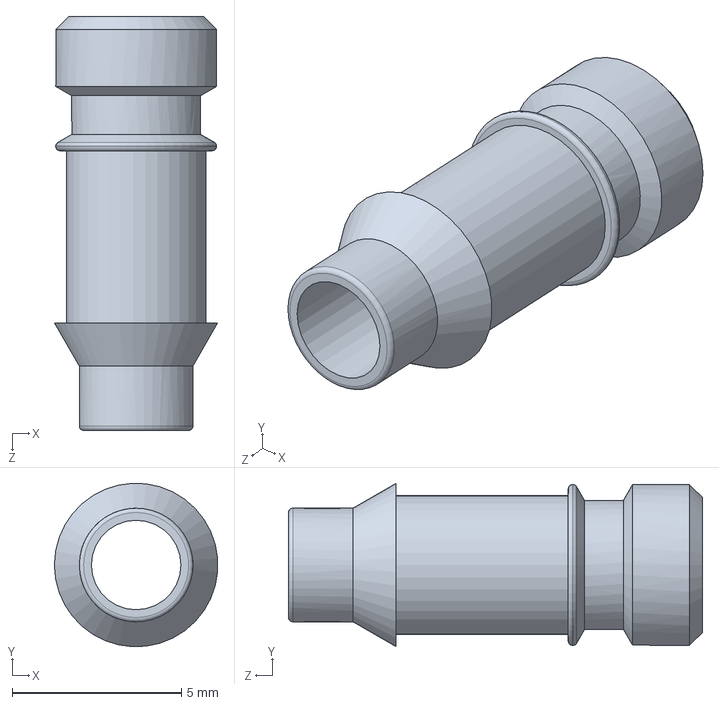
[picture p45: CAD file, 2022-05-25]
CAD/ASSM - Second Stage Regulator/4cq4-pkg_02.SLDPRT
4.82 x 4.82 x 12.2 mm
