anthnt/RSS_Capstone2021/CAD/ASSM - Load Cell/Calibration Plate.SLDPRT

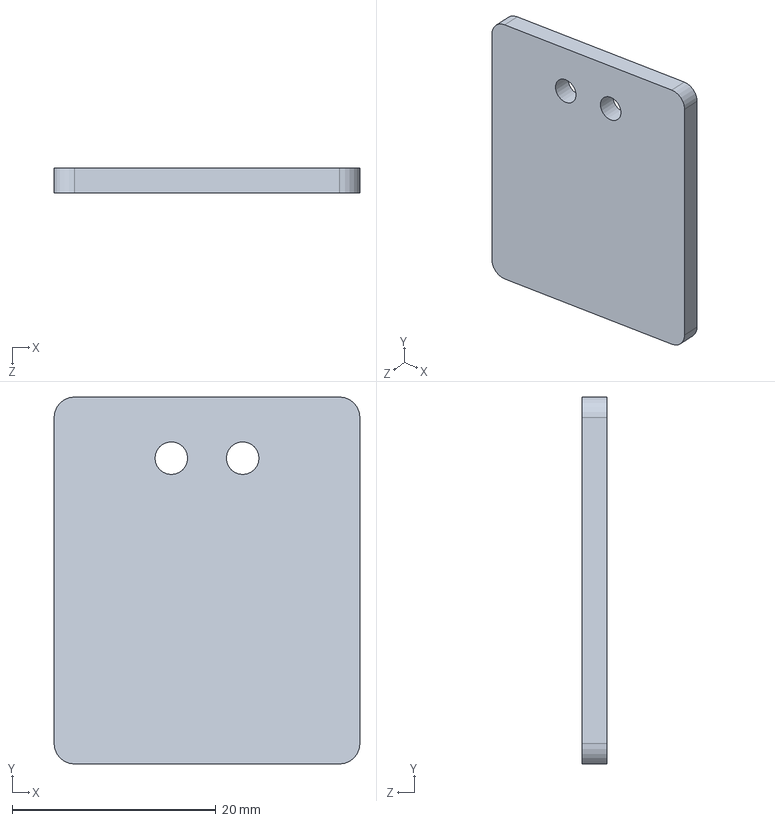
[picture p46: CAD file, 2022-05-25]
CAD/ASSM - Load Cell/Calibration Plate.SLDPRT
30.0 x 36.0 x 2.50 mm
