anthnt/RSS_Capstone2021/CAD/ASSM - Air Cannister/M28_Air Cannister Holder.SLDPRT

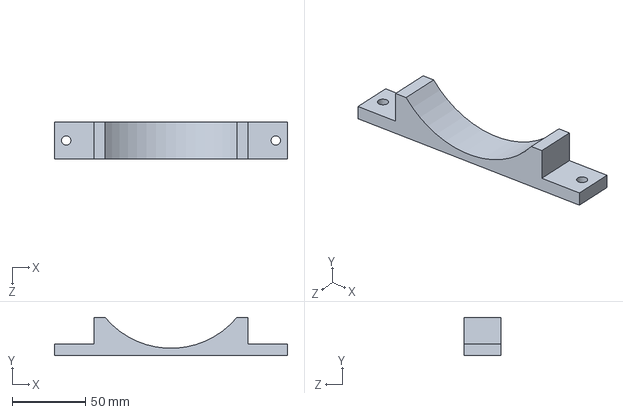
[picture p47: CAD file, 2022-05-25]
CAD/ASSM - Air Cannister/M28_Air Cannister Holder.SLDPRT
159.1 x 26.1 x 25.4 mm
