anthnt/RSS_Capstone2021/CAD/ASSM - Load Cell/M40_Calibration Stand.SLDPRT

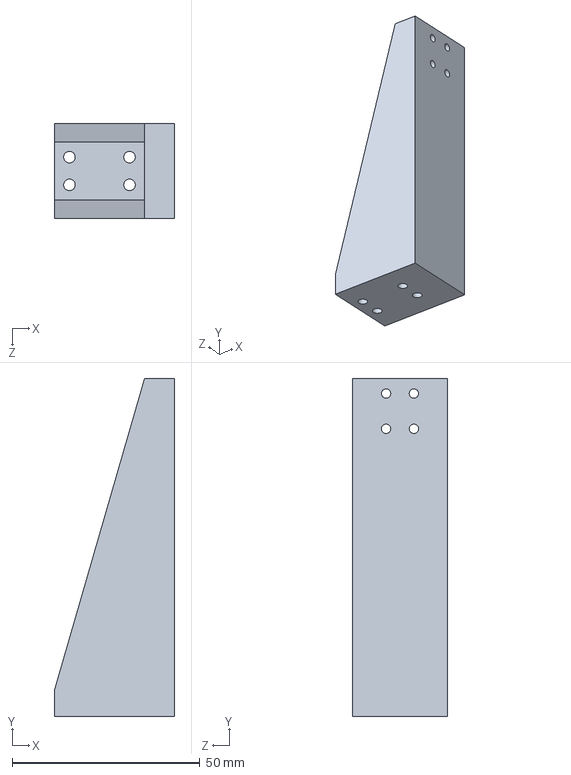
[picture p48: CAD file, 2022-05-25]
CAD/ASSM - Load Cell/M40_Calibration Stand.SLDPRT
32.0 x 90.0 x 25.4 mm
