anthnt/RSS_Capstone2021/CAD/ASSM - Second Stage Regulator/Accutek_PG-160CD15_(0-160 PSI Dry Pressure Gauge).SLDPRT

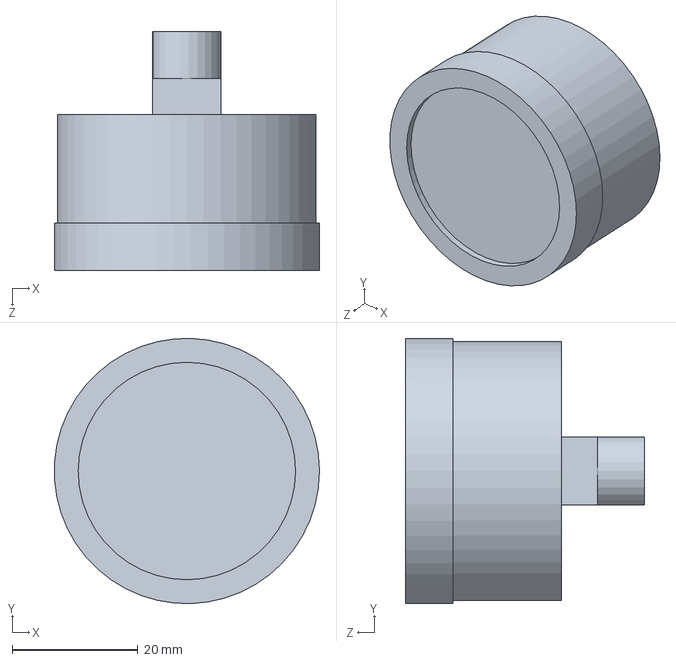
[picture p49: CAD file, 2022-05-25]
CAD/ASSM - Second Stage Regulator/Accutek_PG-160CD15_(0-160 PSI Dry Pressure Gauge).SLDPRT
42.2 x 42.2 x 38.1 mm
