anthnt/RSS_Capstone2021/(list of files, cad)

Other CAD files:
CAD/ASSM - Solenoid Valves and Manifold/valve_e210a-1w012_01.SLDPRT
CAD/ASSM - Second Stage Regulator/4cq4-pkg_01.SLDPRT
CAD/ASSM - Solenoid Valves and Manifold/valve_e210a-1w012_02.SLDPRT
CAD/ASSM - Solenoid Valves and Manifold/valve_e210a-1w012_04.SLDPRT
CAD/ASSM - Solenoid Valves and Manifold/valve_e210a-1w012_03.SLDPRT
CAD/ASSM - 3 Nozzle Section/Archive/3 Nozzle Assembly.SLDASM
CAD/ASSM - 3 Nozzle Section/Archive/M22_3 Nozzle Holder.SLDPRT
CAD/ASSM - 3 Nozzle Section/Archive/M22_3 Nozzle Holder.STL
CAD/ASSM - 3 Nozzle Section/M22b_3 Nozzle Holder.STL
CAD/ASSM - 3 Nozzle Section/M37_90751A118_18-8 Stainless Steel Socket Head Screws.SLDPRT
CAD/ASSM - 3 Nozzle Section/M38_98689A113_General Purpose 18-8 Stainless Steel Washer.SLDPRT
CAD/ASSM - 3 Nozzle Section/M41_91292A801_18-8 Stainless Steel Socket Head Screw.SLDPRT
CAD/ASSM - 3 Nozzle Section/M42_91828A211_18-8 Stainless Steel Hex Nut.SLDPRT
CAD/ASSM - Air Cannister/M19_5346K11_Brass Barbed Hose Fitting for Air and Water.SLDPRT
CAD/ASSM - Air Cannister/M28_Air Cannister Holder.STL
CAD/ASSM - Air Cannister/M35_91292A073_18-8 Stainless Steel Socket Head Screw.SLDPRT
CAD/ASSM - Electrical Board/93655A096_Male-Female Threaded Hex Standoff.SLDPRT
CAD/ASSM - Electrical Board/ElectricalBoard_V2.STL
CAD/ASSM - Load Cell/Archive/91292A123_18-8 Stainless Steel Socket Head Screw.SLDPRT
CAD/ASSM - Load Cell/Archive/92605A913_Stainless Steel Flat-Tip Set Screw.SLDPRT
CAD/ASSM - Load Cell/Archive/Face Plate.SLDPRT
CAD/ASSM - Load Cell/Archive/Load Cell Assembly.SLDASM
CAD/ASSM - Load Cell/Archive/M23_Load Cell Plate.SLDPRT
CAD/ASSM - Load Cell/Archive/M24_Nozzle Mount.SLDPRT
CAD/ASSM - Load Cell/Archive/M25_91292A020_18-8 Stainless Steel Socket Head Screw.SLDPRT
CAD/ASSM - Load Cell/Archive/M25_91292A836_18-8 Stainless Steel Socket Head Screw.SLDPRT
CAD/ASSM - Load Cell/Archive/M26_91828A113_18-8 Stainless Steel Hex Nut.SLDPRT
CAD/ASSM - Load Cell/Calibration Plate.STL
CAD/ASSM - Load Cell/M25_91292A115_18-8 Stainless Steel Socket Head Screw.SLDPRT
CAD/ASSM - Load Cell/M41_91292A801_18-8 Stainless Steel Socket Head Screw.SLDPRT
CAD/ASSM - Load Cell/M43_91292A029_18-8 Stainless Steel Socket Head Screw.SLDPRT
CAD/ASSM - Load Cell/M44_91292A113_18-8 Stainless Steel Socket Head Screw.SLDPRT
CAD/ASSM - Nozzle Assembly/M21_5058K956_ALUMINUM LOW-PRESSURE BARBED TUBE FITTING.SLDPRT
CAD/ASSM - Nozzle Assembly/M27_93020A775_LOW-STRENGTH STL HEX CPLG NUT.SLDPRT
CAD/ASSM - Prototyping Bed/PrototypeBase.STL
CAD/ASSM - Second Stage Regulator/Archive/New Second Stage Regulator Stand.SLDPRT
CAD/ASSM - Second Stage Regulator/Archive/Second Stage Regulator Stand.SLDPRT
CAD/ASSM - Second Stage Regulator/M18_5346K12_Brass Barbed Hose Fitting for Air and Water.SLDPRT
CAD/ASSM - Second Stage Regulator/M43_91292A029_18-8 Stainless Steel Socket Head Screw.SLDPRT
CAD/ASSM - Second Stage Regulator/M45_92005A727_Steel Pan Head Phillips Screw.SLDPRT
CAD/ASSM - Second Stage Regulator/MCMASTER_4464K561_(0.125 NPT Plug Fitting).SLDPRT
CAD/ASSM - Second Stage Regulator/MCMASTER_50915K315_(0.25 NPT x 0.25 Compression).SLDPRT
CAD/ASSM - Second Stage Regulator/Regulator Base Fixture.STL
CAD/ASSM - Solenoid Valves and Manifold/91292A801_18-8 Stainless Steel Socket Head Screw.SLDPRT
CAD/ASSM - Solenoid Valves and Manifold/M10_11752-4-pkg.SLDPRT
CAD/ASSM - Solenoid Valves and Manifold/M11_11752-5-pkg.SLDPRT
CAD/DRAWINGS/Air Cannister Holder/Air Cannister Holder.SLDDRW
CAD/DRAWINGS/Archive/Load Cell Plate.SLDDRW
CAD/DRAWINGS/Archive/M22_3 Nozzle Holder.SLDDRW
CAD/DRAWINGS/Archive/Manifold Stand.SLDDRW
CAD/DRAWINGS/Archive/Nozzle Mount.SLDDRW
CAD/DRAWINGS/M22b_3 Nozzle Block.SLDDRW
CAD/DRAWINGS/M23_Load Cell Bracket.SLDDRW
CAD/DRAWINGS/M24_Nozzle Mount.SLDDRW
CAD/DRAWINGS/M29_Air Cannister Bracket.SLDDRW
CAD/DRAWINGS/M31_BASE.SLDDRW
CAD/DRAWINGS/M40_Calibration Stand.SLDDRW
CAD/DRAWINGS/Old/Not Necesssary/M20_Creality Brass Nozzle.SLDDRW
CAD/DRAWINGS/Old/Not Necesssary/M2_Ninja Canister Assembly.SLDDRW
CAD/DRAWINGS/Old/Not Necesssary/M9_SPEEDAIR REGULATOR.SLDDRW
CAD/DRAWINGS/Old/Not Necesssary/New Load Cell Assembly.SLDDRW
CAD/DRAWINGS/Old/Not Necesssary/Solenoid Manifold.SLDDRW
CAD/DRAWINGS/Old/Not Necesssary/Solenoid Valves.SLDDRW
CAD/PARTS - Prototype Thrusters/Archived Thrusters/ConvergingDiverging_T2.6_E3.0278.SLDPRT
CAD/PARTS - Prototype Thrusters/Archived Thrusters/ConvergingDiverging_T2_E2.3291.SLDPRT
