anthnt/RSS_Capstone2021/CAD/DRAWINGS/M40_Calibration Stand.pdf

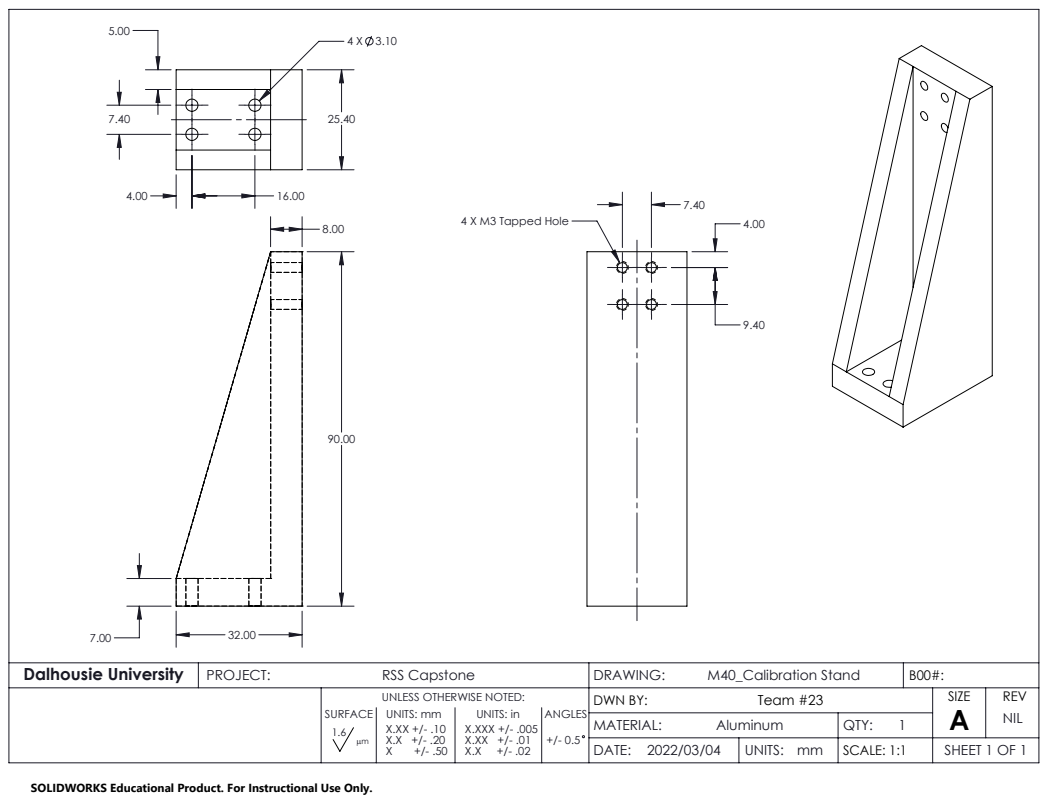
[picture p58: page 1]
4 X M3 Tapped Hole; UNITS: mm; UNITS: in; ANGLES; X.XXX +/- .005 X.XX +/- .01 X.X +/- .02

Dalhousie University | PROJECT: RSS Capstone | DRAWING: M40_Calibration Stand | B00#:

UNLESS OTHERWISE NOTED: | DWN BY: Team #23 | SIZE A | REV NIL
MATERIAL: Aluminum | QTY: 1 Pm 1.6

DATE: 2022/03/04 | UNITS: mm | SCALE: 1:1 | SHEET 1 OF 1

SOLIDWORKS Educational Product. For Instructional Use Only.
