anthnt/RSS_Capstone2021/CAD/DRAWINGS/Supplier Drawings/M14_4464K561_Low-Pressure 302 Stainless Steel Plug with Hex Drive.PDF

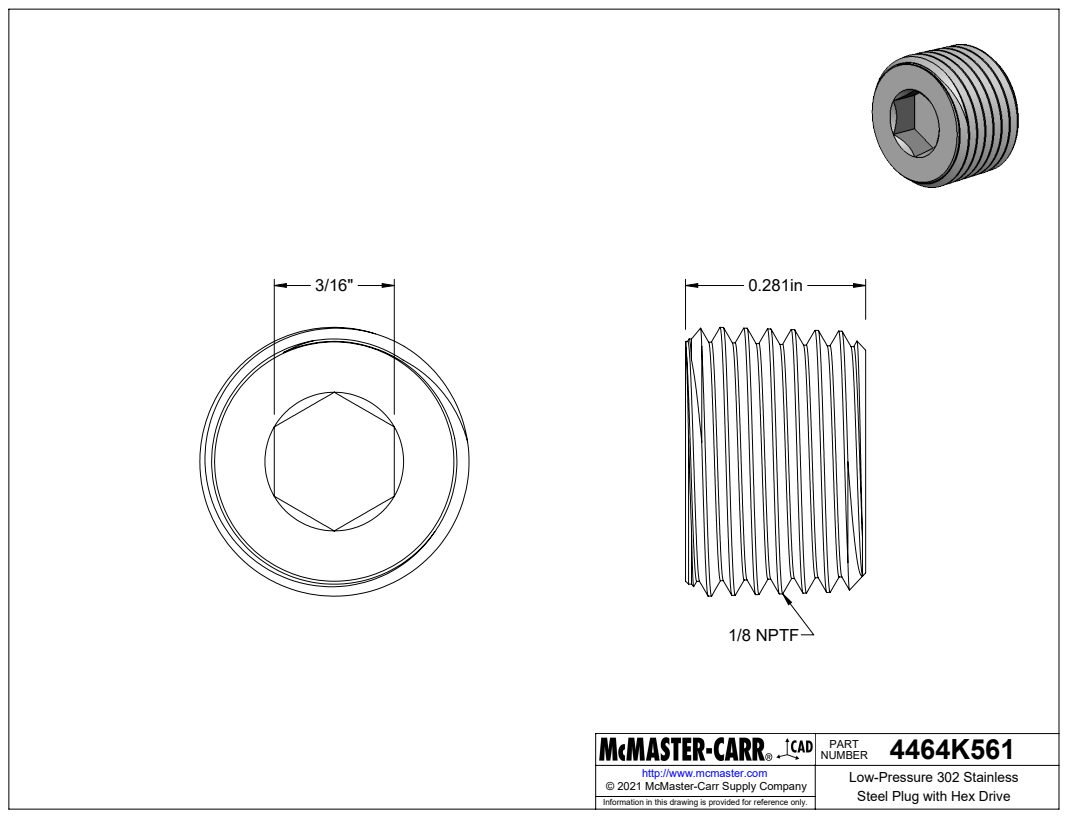
[picture p59: page 1]
1/8 NPTF

4464K561 PART NUMBER

http://www.mcmaster.com | Low-Pressure 302 Stainless Steel Plug with Hex Drive © 2021 McMaster-Carr Supply Company

Information in this drawing is provided for reference only.
