anthnt/RSS_Capstone2021/CAD/DRAWINGS/Supplier Drawings/M21_5058K956_Aluminum Low-Pressure Barbed Tube Fitting.PDF

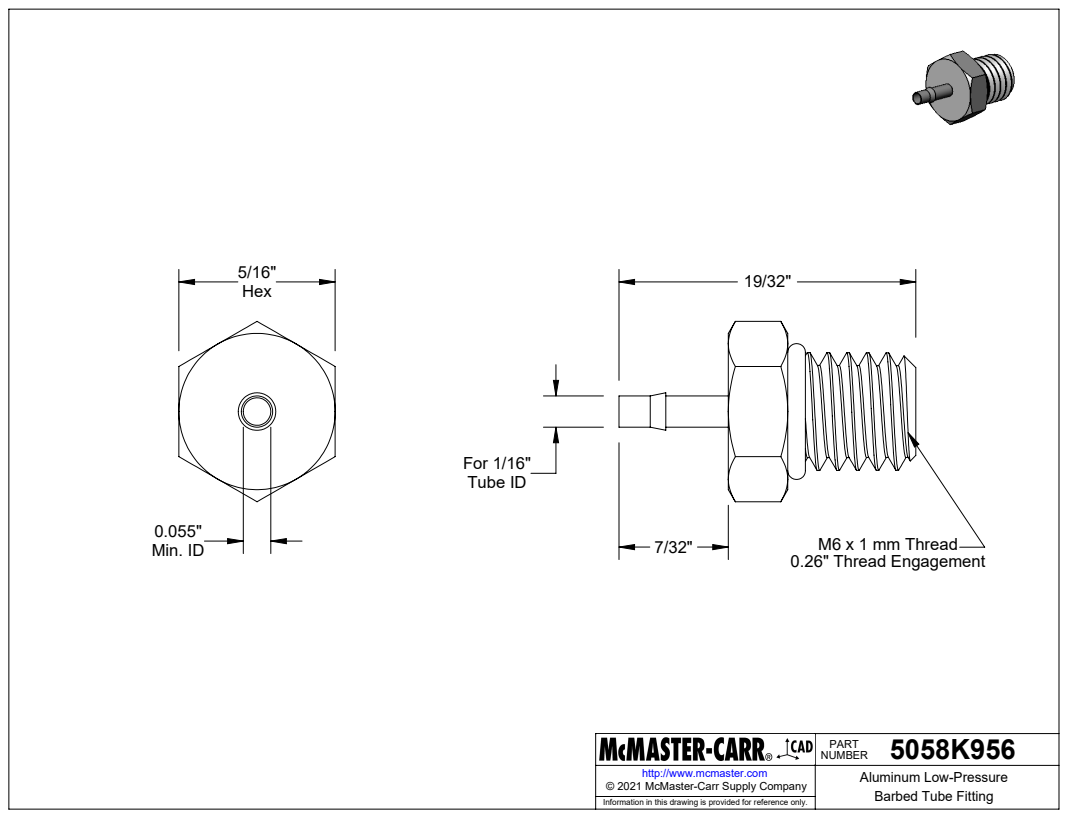
[picture p60: page 1]
Min. ID; For 1/16" Tube ID; M6 x 1 mm Thread; 0.26" Thread Engagement

5058K956 PART NUMBER

http://www.mcmaster.com | Aluminum Low-Pressure Barbed Tube Fitting © 2021 McMaster-Carr Supply Company

Information in this drawing is provided for reference only.
