anthnt/RSS_Capstone2021/CAD/DRAWINGS/Supplier Drawings/M25_91292A836_18-8 Stainless Steel Socket Head Screw.PDF

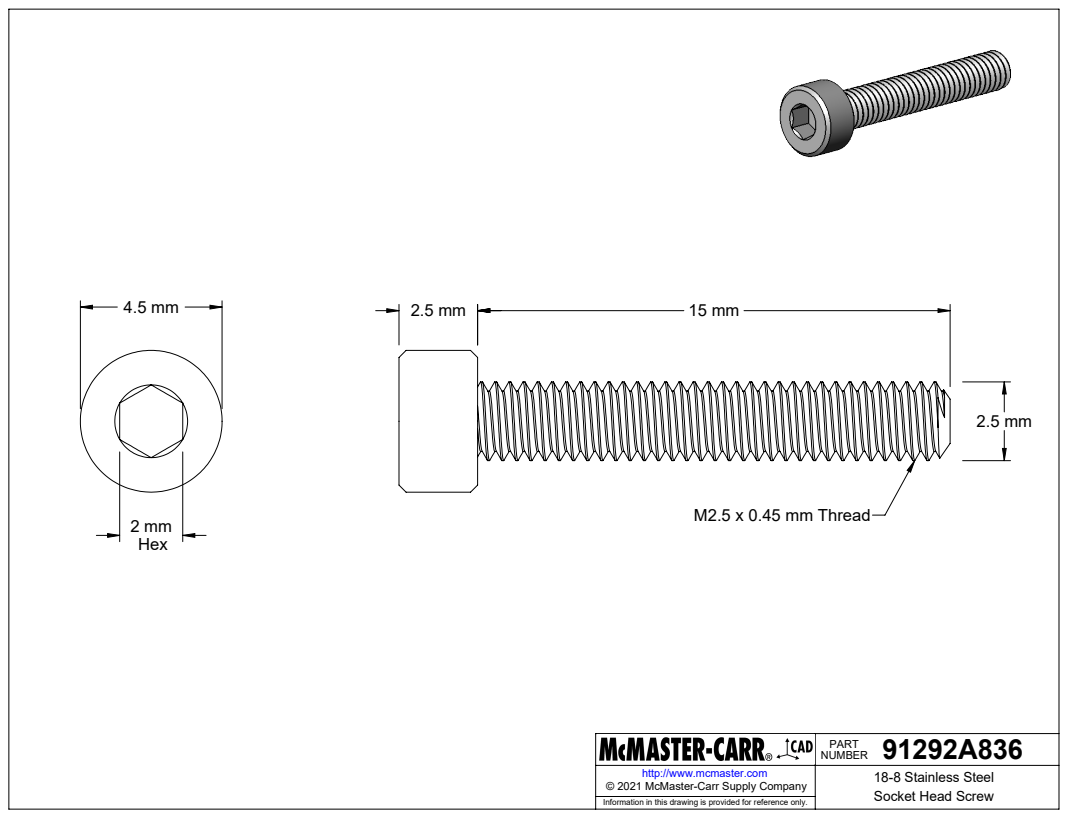
[picture p61: page 1]
M2.5 x 0.45 mm Thread

91292A836 PART NUMBER

http://www.mcmaster.com | 18-8 Stainless Steel Socket Head Screw © 2021 McMaster-Carr Supply Company

Information in this drawing is provided for reference only.
