anthnt/RSS_Capstone2021/CAD/DRAWINGS/Supplier Drawings/M26_91828A113_18-8 Stainless Steel Hex Nut.PDF

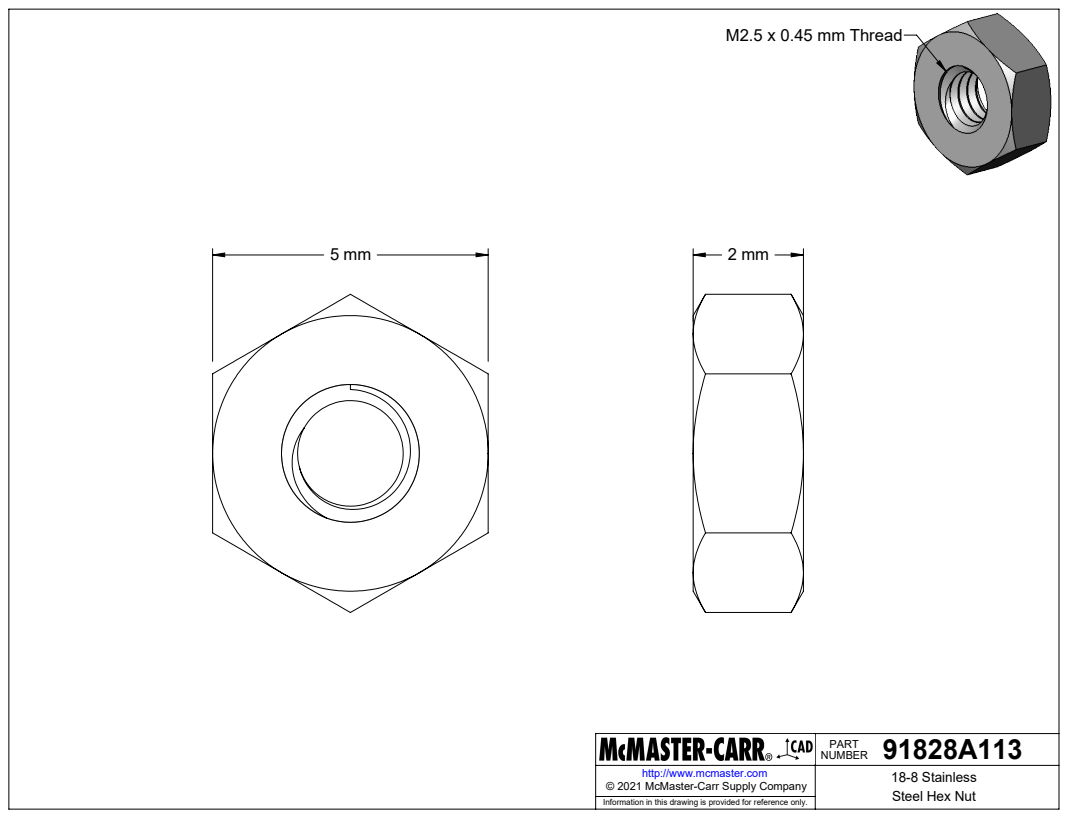
[picture p62: page 1]
M2.5 x 0.45 mm Thread

91828A113 PART NUMBER

http://www.mcmaster.com | 18-8 Stainless Steel Hex Nut © 2021 McMaster-Carr Supply Company

Information in this drawing is provided for reference only.
