anthnt/RSS_Capstone2021/CAD/DRAWINGS/Supplier Drawings/M27_93020A775_Low-Strength Steel Coupling Nut.PDF

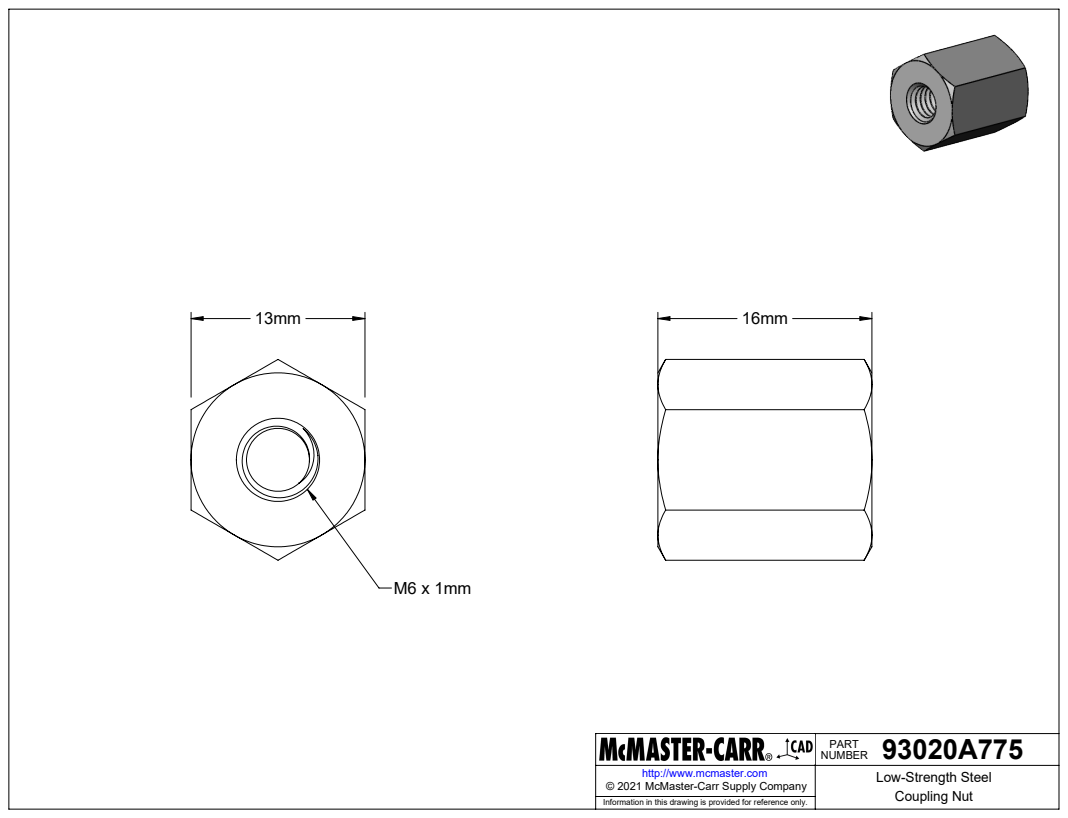
[picture p63: page 1]

93020A775 PART NUMBER

http://www.mcmaster.com | Low-Strength Steel Coupling Nut © 2021 McMaster-Carr Supply Company

Information in this drawing is provided for reference only.
