anthnt/RSS_Capstone2021/CAD/DRAWINGS/M22b_3 Nozzle Block.pdf

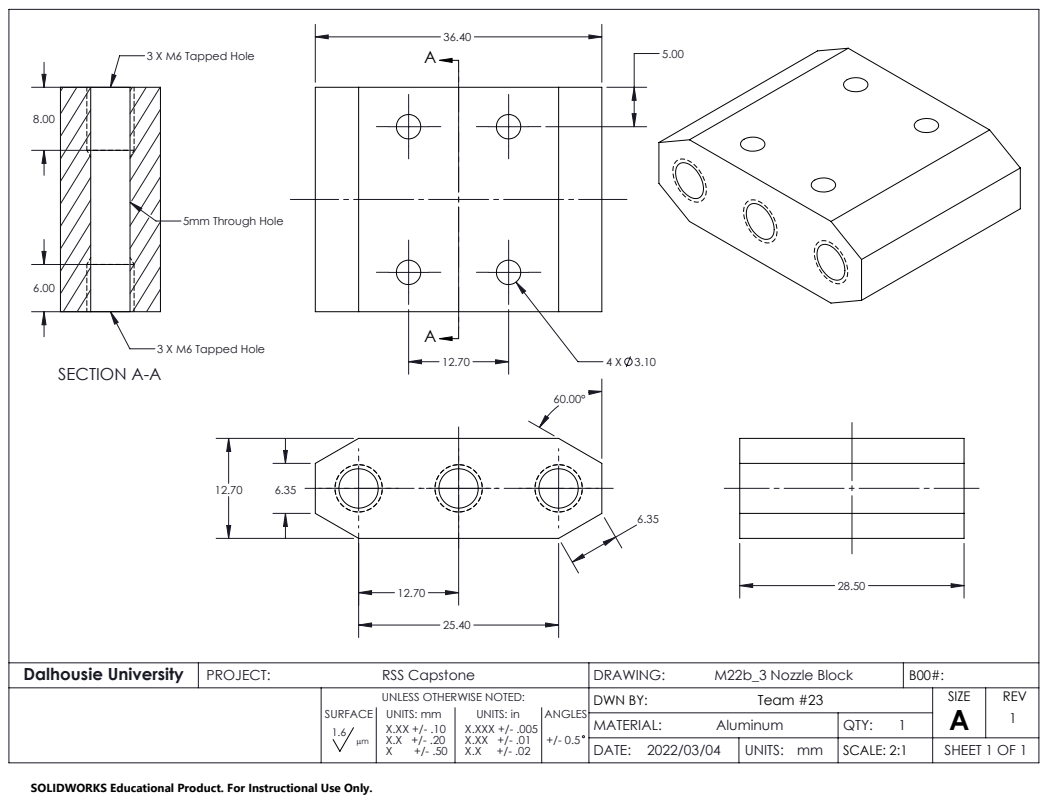
[picture p64: page 1]
SECTION A-A; 3 X M6 Tapped Hole; 5mm Through Hole; UNITS: mm; UNITS: in; ANGLES; X.XXX +/- .005 X.XX +/- .01 X.X +/- .02

Dalhousie University | PROJECT: RSS Capstone | DRAWING: M22b_3 Nozzle Block | B00#:

UNLESS OTHERWISE NOTED: | DWN BY: Team #23 | SIZE A | REV 1
MATERIAL: Aluminum | QTY: 1 Pm 1.6

DATE: 2022/03/04 | UNITS: mm | SCALE: 2:1 | SHEET 1 OF 1

SOLIDWORKS Educational Product. For Instructional Use Only.
