anthnt/RSS_Capstone2021/CAD/DRAWINGS/M23_Load Cell Bracket.pdf

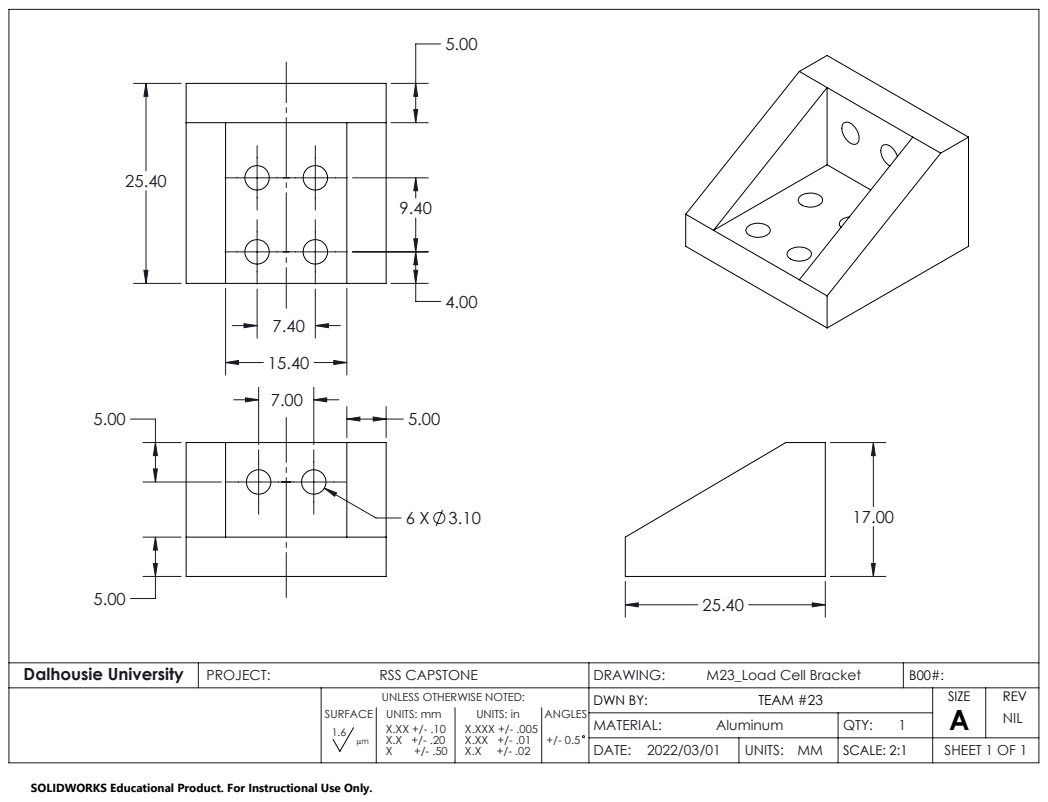
[picture p65: page 1]
UNITS: mm; UNITS: in; ANGLES; X.XXX +/- .005 X.XX +/- .01 X.X +/- .02

Dalhousie University | PROJECT: RSS CAPSTONE | DRAWING: M23_Load Cell Bracket | B00#:

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

DATE: 2022/03/01 | UNITS: MM | SCALE: 2:1 | SHEET 1 OF 1

SOLIDWORKS Educational Product. For Instructional Use Only.
