anthnt/RSS_Capstone2021/CAD/DRAWINGS/M24_Nozzle Mount.pdf

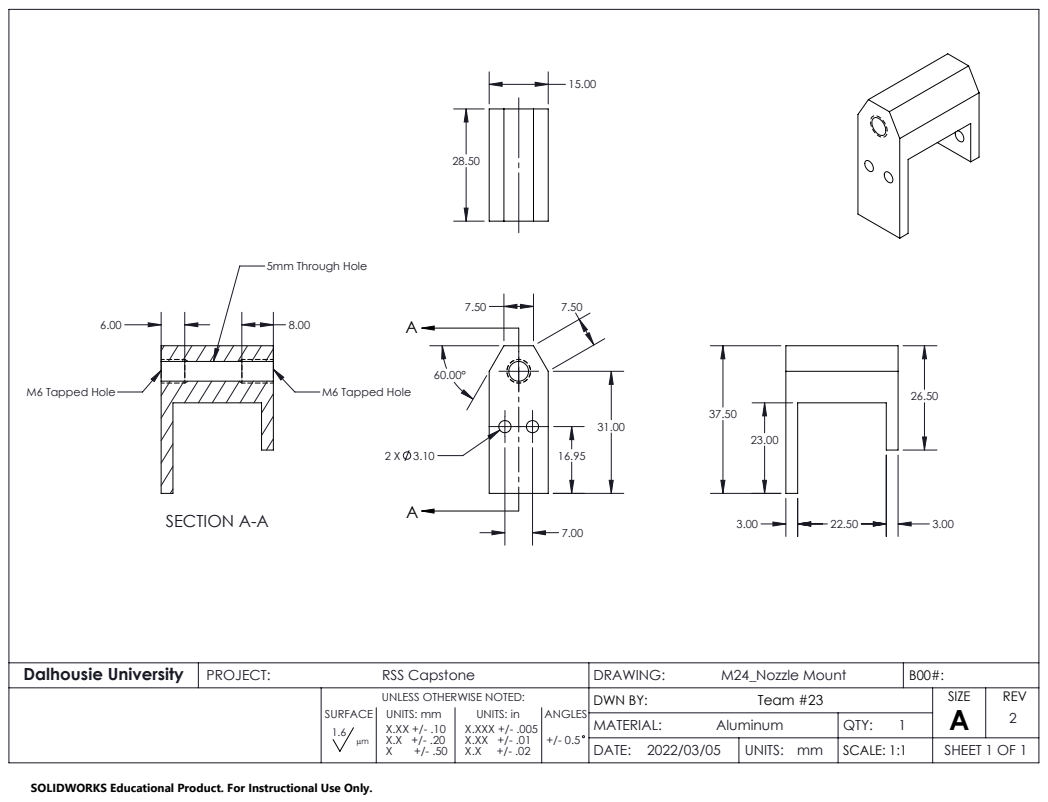
[picture p66: page 1]
SECTION A-A; M6 Tapped Hole; 5mm Through Hole; UNITS: mm; UNITS: in; ANGLES; X.XXX +/- .005 X.XX +/- .01 X.X +/- .02

Dalhousie University | PROJECT: RSS Capstone | DRAWING: M24_Nozzle Mount | B00#:

UNLESS OTHERWISE NOTED: | DWN BY: Team #23 | SIZE A | REV 2
MATERIAL: Aluminum | QTY: 1 Pm 1.6

DATE: 2022/03/05 | UNITS: mm | SCALE: 1:1 | SHEET 1 OF 1

SOLIDWORKS Educational Product. For Instructional Use Only.
