anthnt/RSS_Capstone2021/CAD/DRAWINGS/M29_Air Cannister Bracket.pdf

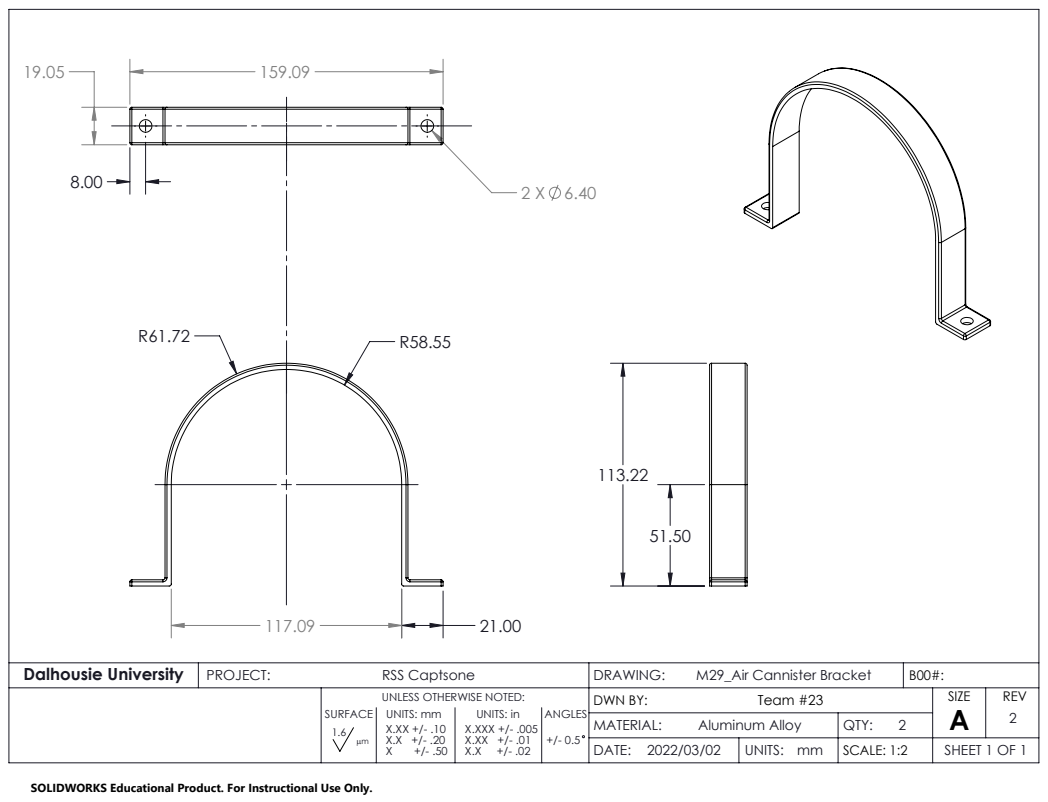
[picture p67: page 1]
UNITS: mm; UNITS: in; ANGLES; X.XXX +/- .005 X.XX +/- .01 X.X +/- .02

Dalhousie University | PROJECT: RSS Captsone | DRAWING: M29_Air Cannister Bracket | B00#:

UNLESS OTHERWISE NOTED: | DWN BY: Team #23 | SIZE A | REV 2
MATERIAL: Aluminum Alloy | QTY: 2 Pm 1.6

DATE: 2022/03/02 | UNITS: mm | SCALE: 1:2 | SHEET 1 OF 1

SOLIDWORKS Educational Product. For Instructional Use Only.
