anthnt/RSS_Capstone2021/CAD/DRAWINGS/M31_BASE.pdf

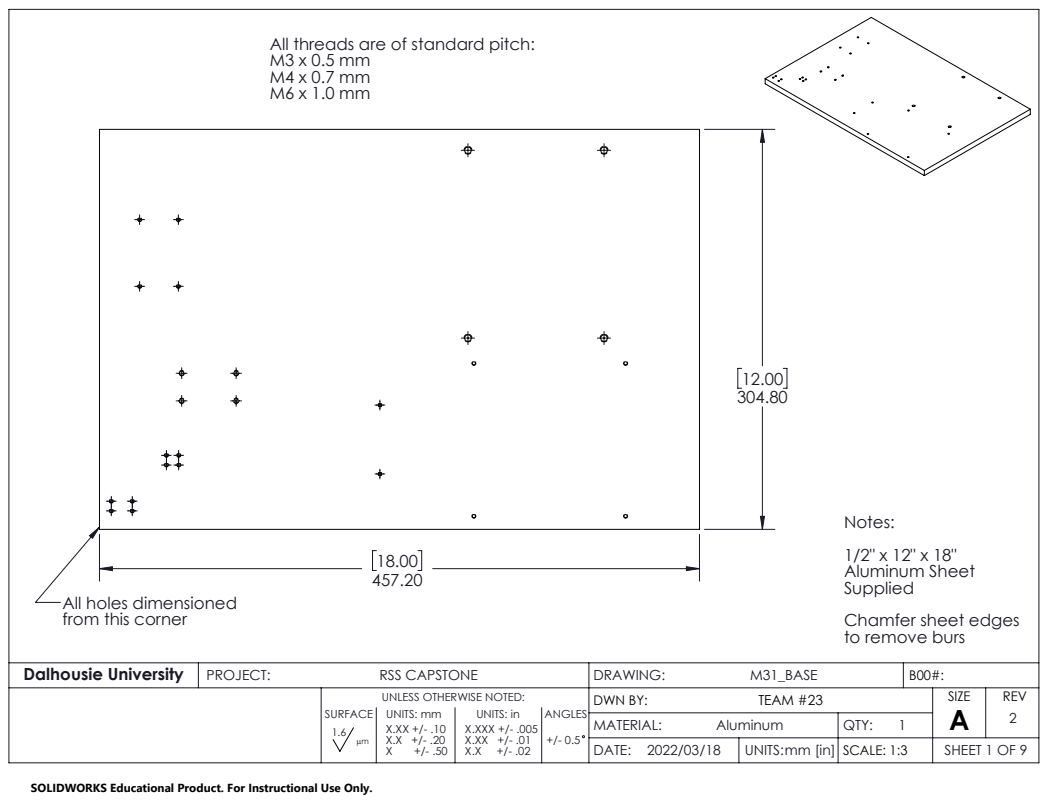
[picture p68: page 1]
UNITS: mm; UNITS: in; ANGLES; X.XXX +/- .005 X.XX +/- .01 X.X +/- .02

All threads are of standard pitch:

Notes:
Aluminum Sheet
Supplied
Chamfer sheet edges
to remove burs

All holes dimensioned
from this corner

Dalhousie University | PROJECT: RSS CAPSTONE | DRAWING: M31_BASE | B00#:

UNLESS OTHERWISE NOTED: | DWN BY: TEAM #23 | SIZE A | REV 2
MATERIAL: Aluminum | QTY: 1 Pm 1.6

DATE: 2022/03/18 | UNITS: mm [in] | SCALE: 1:3 | SHEET 1 OF 9

SOLIDWORKS Educational Product. For Instructional Use Only.

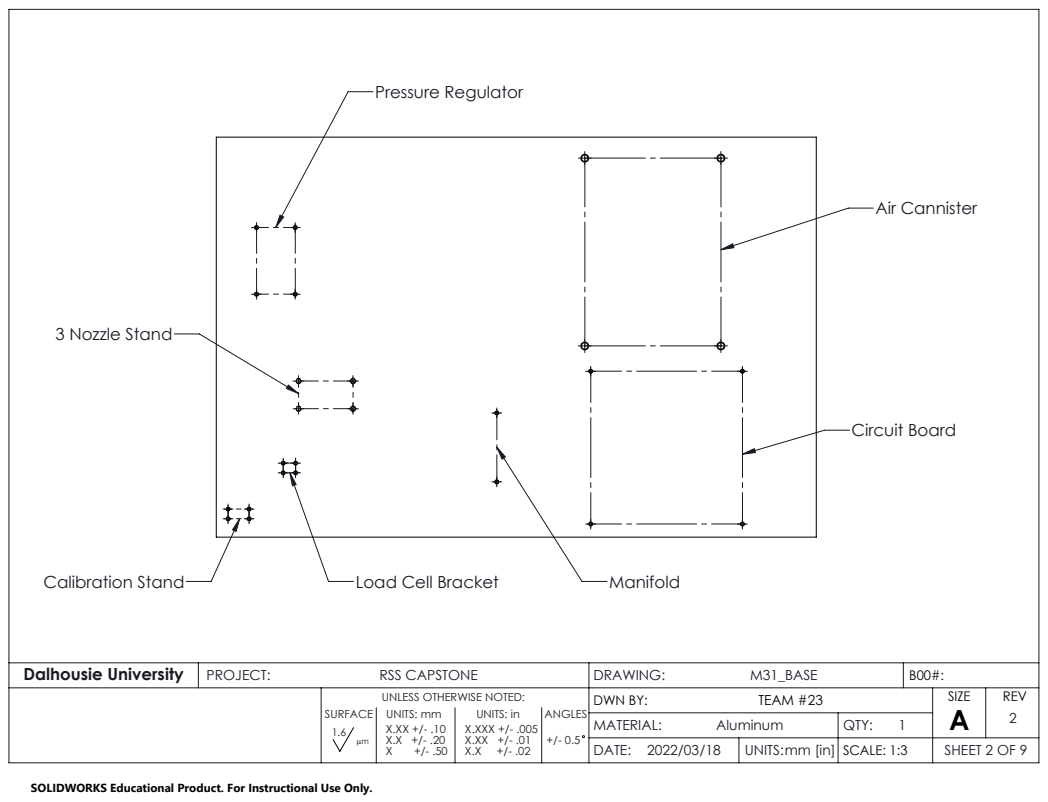
[picture p69: page 2]
Calibration Stand; Load Cell Bracket; Circuit Board; Air Cannister; Pressure Regulator; 3 Nozzle Stand; UNITS: mm; UNITS: in; ANGLES; X.XXX +/- .005

Dalhousie University | PROJECT: RSS CAPSTONE | DRAWING: M31_BASE | B00#:

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

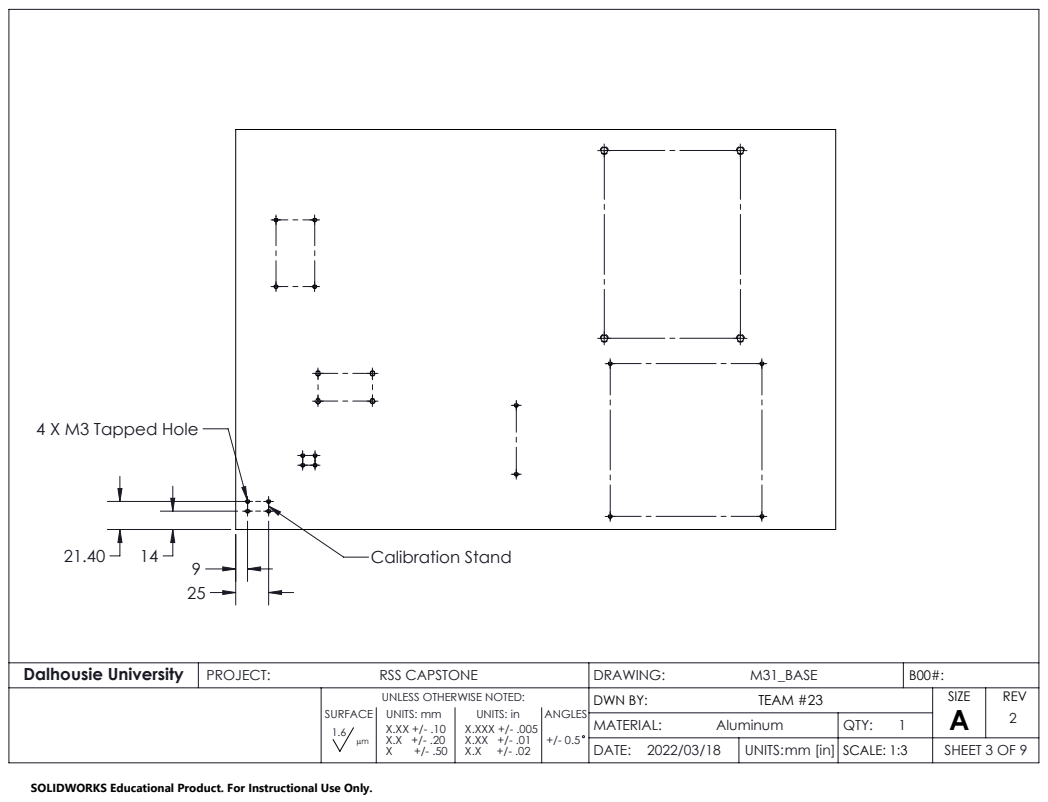
[picture p70: page 3]
4 X M3 Tapped Hole; Calibration Stand; UNITS: mm; UNITS: in; ANGLES; X.XXX +/- .005

Dalhousie University | PROJECT: RSS CAPSTONE | DRAWING: M31_BASE | B00#:

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

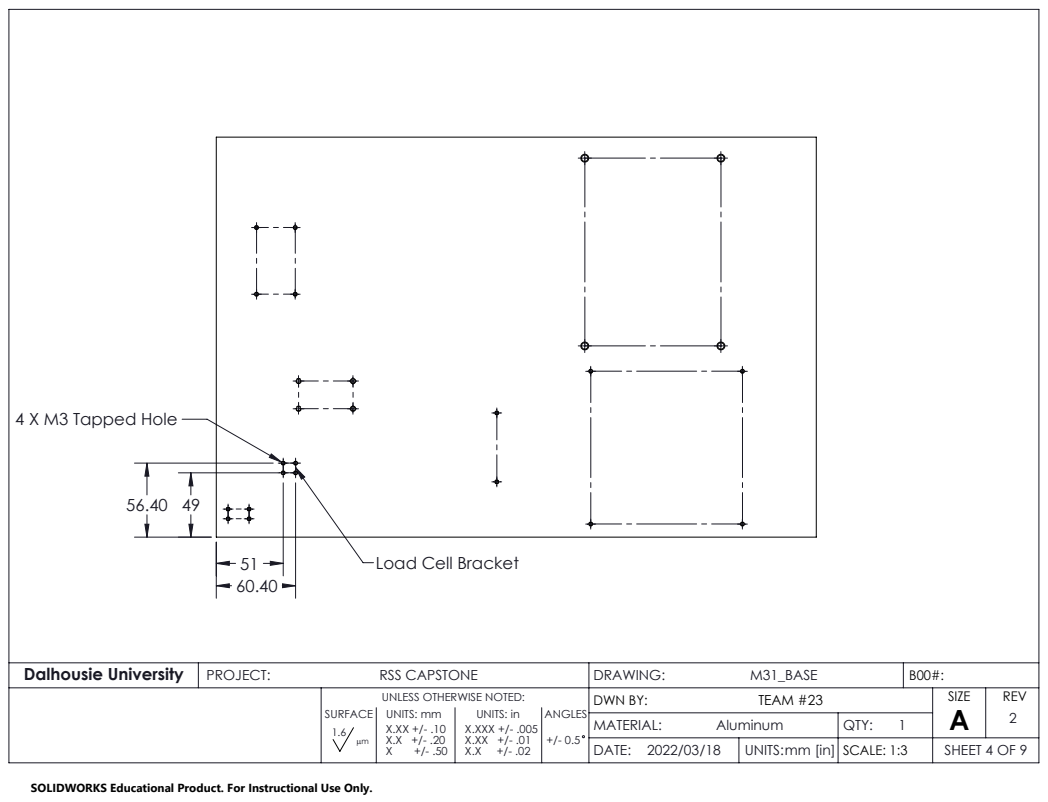
[picture p71: page 4]
4 X M3 Tapped Hole; UNITS: mm; UNITS: in; ANGLES; X.XXX +/- .005

Load Cell Bracket

Dalhousie University | PROJECT: RSS CAPSTONE | DRAWING: M31_BASE | B00#:

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

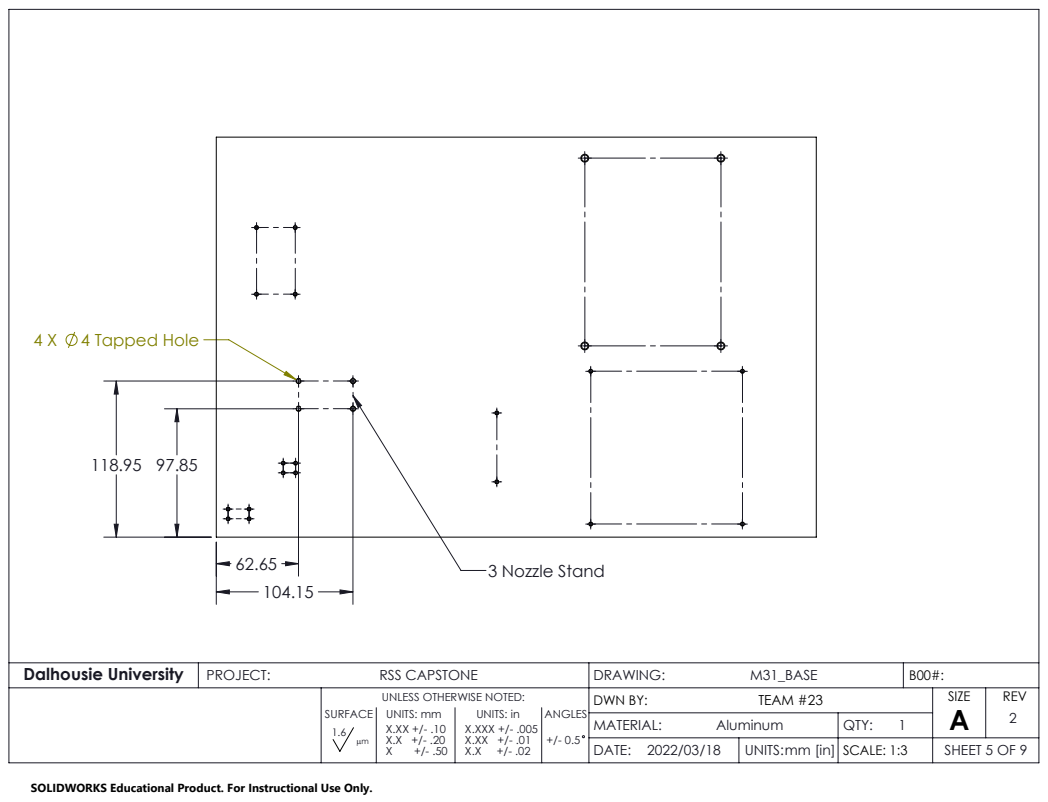
[picture p72: page 5]
4 X 4 Tapped Hole; 3 Nozzle Stand; UNITS: mm; UNITS: in; ANGLES; X.XXX +/- .005

Dalhousie University | PROJECT: RSS CAPSTONE | DRAWING: M31_BASE | B00#:

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

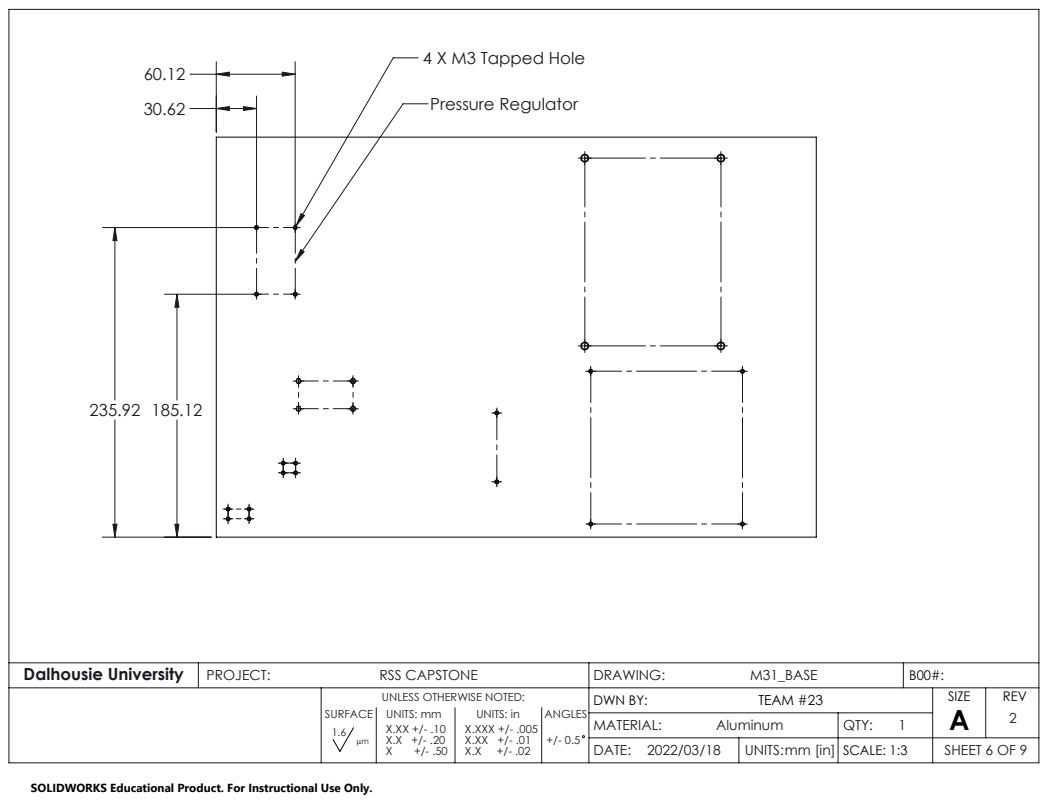
[picture p73: page 6]
4 X M3 Tapped Hole; Pressure Regulator; UNITS: mm; UNITS: in; ANGLES; X.XXX +/- .005

Dalhousie University | PROJECT: RSS CAPSTONE | DRAWING: M31_BASE | B00#:

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

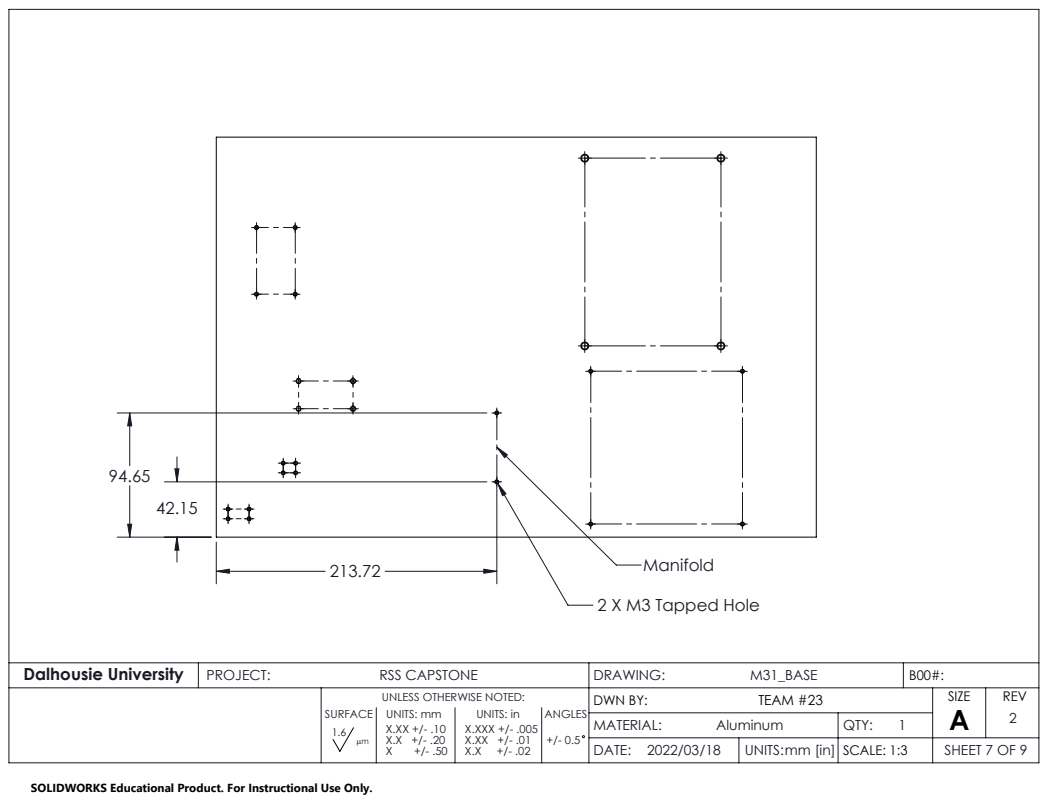
[picture p74: page 7]
2 X M3 Tapped Hole; UNITS: mm; UNITS: in; ANGLES; X.XXX +/- .005

Dalhousie University | PROJECT: RSS CAPSTONE | DRAWING: M31_BASE | B00#:

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

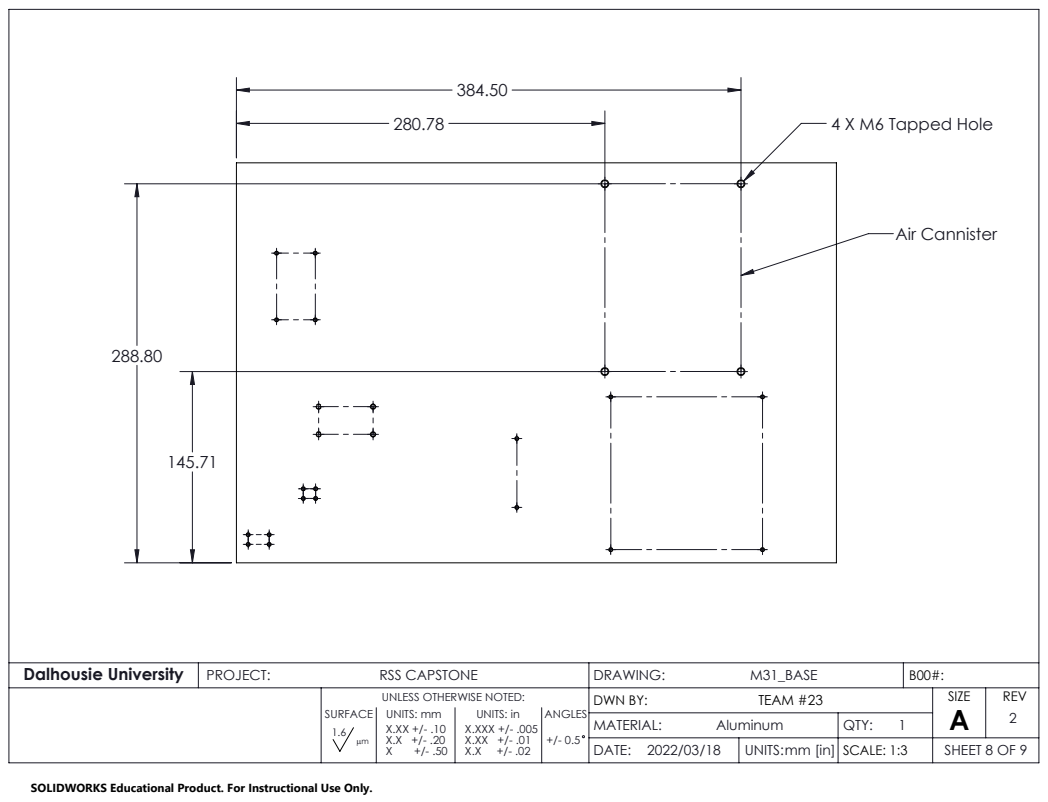
[picture p75: page 8]
4 X M6 Tapped Hole; Air Cannister; UNITS: mm; UNITS: in; ANGLES; X.XXX +/- .005

Dalhousie University | PROJECT: RSS CAPSTONE | DRAWING: M31_BASE | B00#:

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

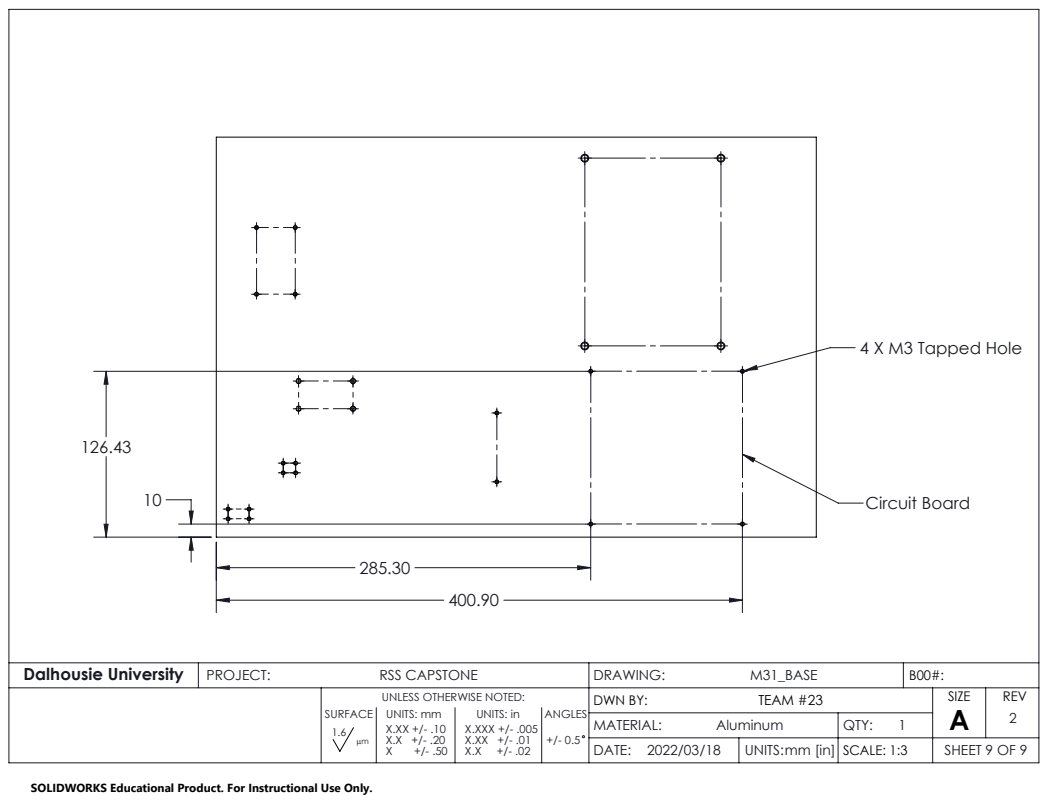
[picture p76: page 9]
4 X M3 Tapped Hole; Circuit Board; UNITS: mm; UNITS: in; ANGLES; X.XXX +/- .005

Dalhousie University | PROJECT: RSS CAPSTONE | DRAWING: M31_BASE | B00#:

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
