anthnt/RSS_Capstone2021/CAD/DRAWINGS/Old/Not Necesssary/M20_Creality Brass Nozzle.pdf

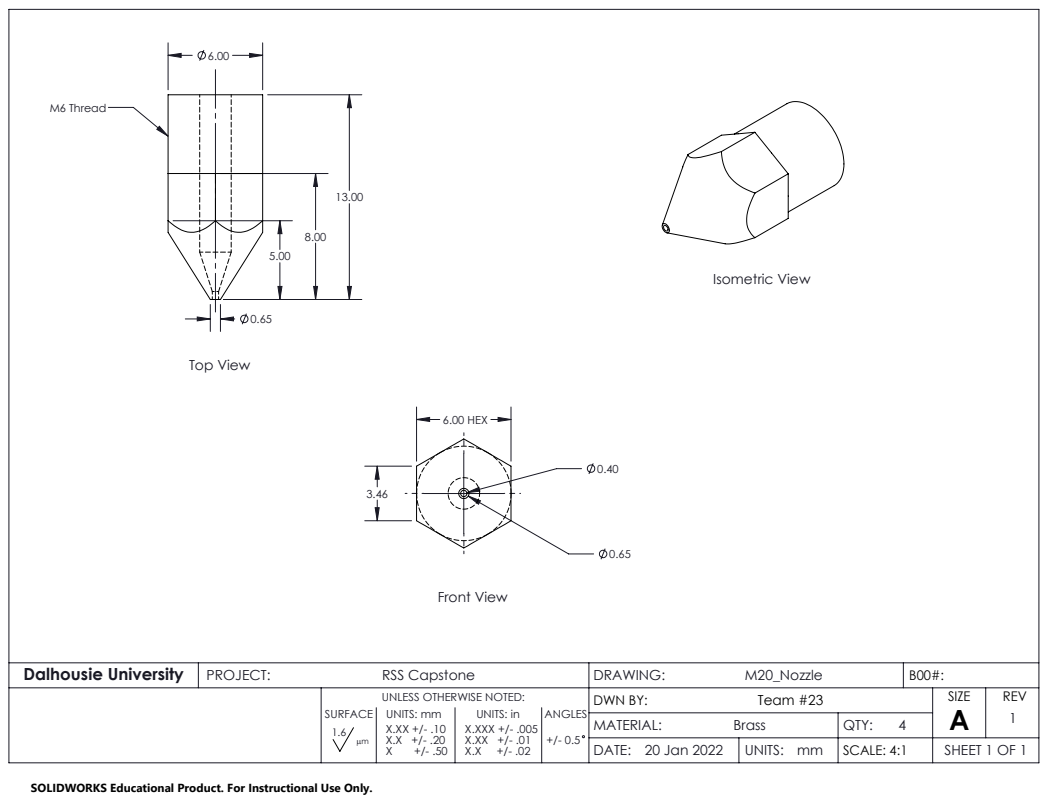
[picture p80: page 1]
6.00 HEX; M6 Thread; Isometric View; Top View; Front View; UNITS: mm; UNITS: in; ANGLES; X.XXX +/- .005 X.XX +/- .01 X.X +/- .02

Dalhousie University | PROJECT: RSS Capstone | DRAWING: M20_Nozzle | B00#:

UNLESS OTHERWISE NOTED: | DWN BY: Team #23 | SIZE A | REV 1
MATERIAL: Brass | QTY: 4 Pm 1.6

DATE: 20 Jan 2022 | UNITS: mm | SCALE: 4:1 | SHEET 1 OF 1

SOLIDWORKS Educational Product. For Instructional Use Only.
