anthnt/RSS_Capstone2021/CAD/DRAWINGS/Old/Not Necesssary/Solenoid Manifold.pdf

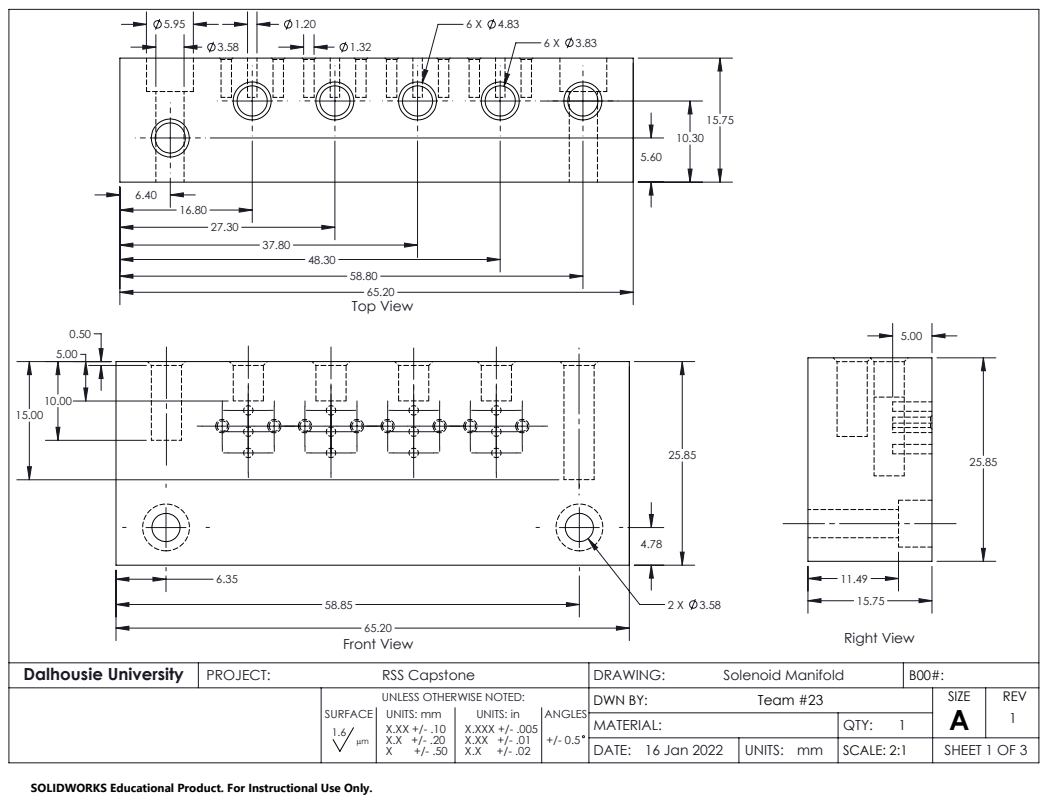
[picture p81: page 1]
Top View; Front View; Right View; UNITS: mm; UNITS: in; ANGLES; X.XXX +/- .005 X.XX +/- .01 X.X +/- .02

Dalhousie University | PROJECT: RSS Capstone | DRAWING: Solenoid Manifold | B00#:

UNLESS OTHERWISE NOTED: | DWN BY: Team #23 | SIZE A | REV 1
MATERIAL: | QTY: 1 Pm 1.6

DATE: 16 Jan 2022 | UNITS: mm | SCALE: 2:1 | SHEET 1 OF 3

SOLIDWORKS Educational Product. For Instructional Use Only.

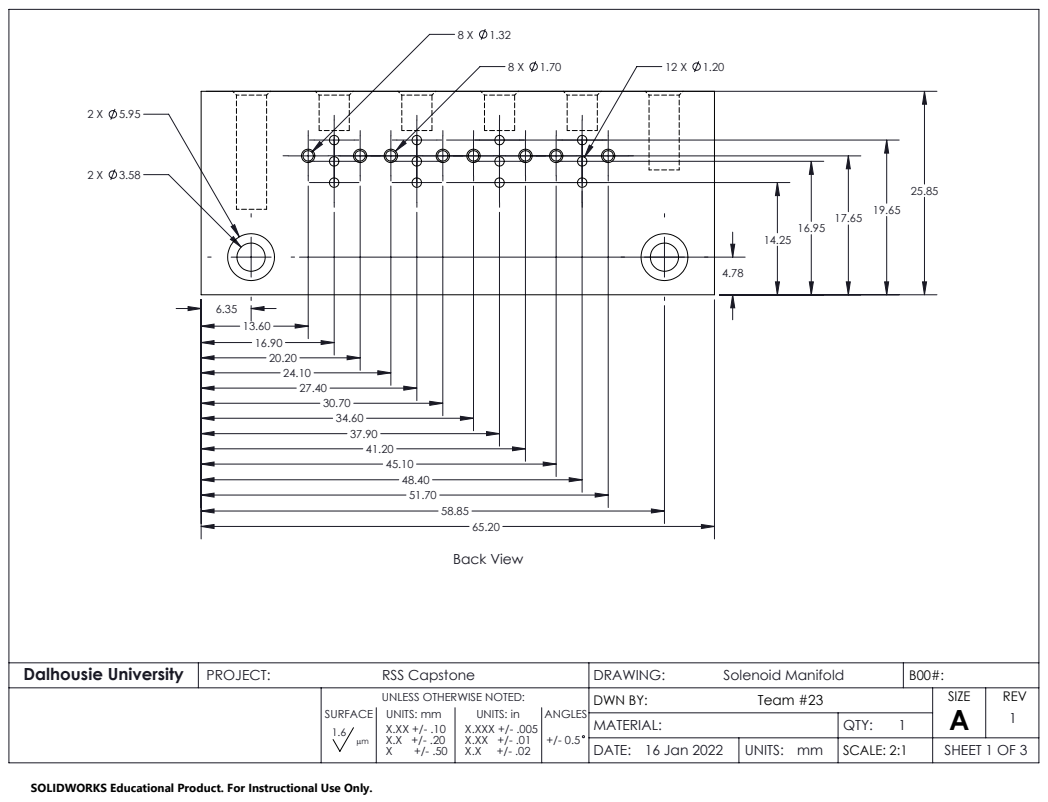
[picture p82: page 2]
Back View; UNITS: mm; UNITS: in; ANGLES; X.XXX +/- .005

Dalhousie University | PROJECT: RSS Capstone | DRAWING: Solenoid Manifold | B00#:

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

Isometric View; UNITS: mm; UNITS: in; ANGLES; X.XXX +/- .005

Dalhousie University | PROJECT: RSS Capstone | DRAWING: Solenoid Manifold | B00#:

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
