anthnt/RSS_Capstone2021/(commit log)

2022-05-25 Adding CAD and CFD folders
2022-05-25 Adding Solidworks files pt.2
    [2 x M28_Air Cannister Holder.3mf, 3 Nozzle Assembly.SLDASM, 4cq4-pkg.SLDASM, 4cq4-pkg_01.SLDPRT, 4cq4-pkg_02.SLDPRT, 91292A123_18-8 Stainless Steel Socket Head Screw.SLDPRT, 91292A801_18-8 Stainless Steel Socket Head Screw.SLDPRT, 92605A913_Stainless Steel Flat-Tip Set Screw.SLDPRT]
